JulienKluge/Clock-odial/README.md

# Clock'odial 🐊

Clock'odial is a PCB board which does frequency and clock signal processing.
