JulienKluge/Clock-odial/extern/LFE5U-25F-6BG256C/Pinout/FPGA-SC-02033-2-0-ECP5U-25-Pinout.xlsx

# Pin Out For ECP5U-25
# Revision 1.1 - Include CABGA256 package
# Revised Oct. 17 | 2017
# Revision 2.0 - Include TQFP144 package
# Revised Sep. 17 | 2021
PAD | Pin/Ball Function | Bank | Dual Function | Differential | High Speed | DQS | CABGA256
1 | PL2A | 7 | - | True_OF_PL2B | TRUE | LDQ8 | B1
2 | PL2B | 7 | - | Comp_OF_PL2A | TRUE | LDQ8 | B2
3 | VSSIO7 | - | - | - | - | - | -
4 | PL2C | 7 | - | True_OF_PL2D | - | LDQ8 | C3
5 | VCCIO7 | - | - | - | - | - | -
6 | PL2D | 7 | - | Comp_OF_PL2C | - | LDQ8 | D3
7 | PL5A | 7 | - | True_OF_PL5B | TRUE | LDQ8 | C1
8 | VCCAUX | - | - | - | - | - | -
9 | PL5C | 7 | - | True_OF_PL5D | - | LDQ8 | E3
10 | PL5B | 7 | - | Comp_OF_PL5A | TRUE | LDQ8 | C2
11 | VSS | - | - | - | - | - | -
12 | PL5D | 7 | - | Comp_OF_PL5C | - | LDQ8 | F3
13 | PL8A | 7 | - | True_OF_PL8B | TRUE | LDQS8 | D1
14 | VCC | - | - | - | - | - | -
15 | PL8C | 7 | - | True_OF_PL8D | - | LDQ8 | F4
16 | PL8B | 7 | - | Comp_OF_PL8A | TRUE | LDQSN8 | E2
17 | VSS | - | - | - | - | - | -
18 | PL8D | 7 | - | Comp_OF_PL8C | - | LDQ8 | F5
19 | PL11A | 7 | - | True_OF_PL11B | TRUE | LDQ8 | G5
20 | VSSIO7 | - | - | - | - | - | -
21 | PL11C | 7 | - | True_OF_PL11D | - | LDQ8 | F2
22 | PL11B | 7 | - | Comp_OF_PL11A | TRUE | LDQ8 | G4
23 | VCCIO7 | - | - | - | - | - | -
24 | PL11D | 7 | - | Comp_OF_PL11C | - | LDQ8 | E1
25 | PL14A | 7 | - | True_OF_PL14B | TRUE | LDQ20 | F1
26 | VSSIO7 | - | - | - | - | - | -
27 | PL14C | 7 | VREF1_7 | True_OF_PL14D | - | LDQ20 | G3
28 | PL14B | 7 | - | Comp_OF_PL14A | TRUE | LDQ20 | G2
29 | VCCIO7 | - | - | - | - | - | -
30 | PL14D | 7 | - | Comp_OF_PL14C | - | LDQ20 | H3
31 | PL17A | 7 | - | True_OF_PL17B | TRUE | LDQ20 | H5
32 | VCCAUX | - | - | - | - | - | -
33 | PL17C | 7 | - | True_OF_PL17D | - | LDQ20 | J4
34 | PL17B | 7 | - | Comp_OF_PL17A | TRUE | LDQ20 | H4
35 | VSS | - | - | - | - | - | -
36 | PL17D | 7 | - | Comp_OF_PL17C | - | LDQ20 | J5
37 | PL20A | 7 | GR_PCLK7_1 | True_OF_PL20B | TRUE | LDQS20 | G1
38 | VCC | - | - | - | - | - | -
39 | PL20C | 7 | GR_PCLK7_0 | True_OF_PL20D | - | LDQ20 | J3
40 | PL20B | 7 | - | Comp_OF_PL20A | TRUE | LDQSN20 | H2
41 | VSS | - | - | - | - | - | -
42 | PL20D | 7 | - | Comp_OF_PL20C | - | LDQ20 | K3
43 | PL23A | 7 | PCLKT7_1 | True_OF_PL23B | TRUE | LDQ20 | J1
44 | VSSIO7 | - | - | - | - | - | -
45 | PL23C | 7 | PCLKT7_0 | True_OF_PL23D | - | LDQ20 | K1
46 | PL23B | 7 | PCLKC7_1 | Comp_OF_PL23A | TRUE | LDQ20 | J2
47 | VCCIO7 | - | - | - | - | - | -
48 | PL23D | 7 | PCLKC7_0 | Comp_OF_PL23C | - | LDQ20 | K2
49 | PL26A | 6 | PCLKT6_1 | True_OF_PL26B | TRUE | LDQ32 | L1
50 | VSSIO6 | - | - | - | - | - | -
51 | PL26C | 6 | PCLKT6_0 | True_OF_PL26D | - | LDQ32 | M1
52 | PL26B | 6 | PCLKC6_1 | Comp_OF_PL26A | TRUE | LDQ32 | L2
53 | VCCIO6 | - | - | - | - | - | -
54 | PL26D | 6 | PCLKC6_0 | Comp_OF_PL26C | - | LDQ32 | M2
55 | PL29A | 6 | GR_PCLK6_0 | True_OF_PL29B | TRUE | LDQ32 | K4
56 | VCCAUX | - | - | - | - | - | -
57 | PL29C | 6 | GR_PCLK6_1 | True_OF_PL29D | - | LDQ32 | L4
58 | PL29B | 6 | - | Comp_OF_PL29A | TRUE | LDQ32 | K5
59 | VSS | - | - | - | - | - | -
60 | PL29D | 6 | - | Comp_OF_PL29C | - | LDQ32 | L5
61 | PL32A | 6 | - | True_OF_PL32B | TRUE | LDQS32 | N1
62 | VCC | - | - | - | - | - | -
63 | PL32C | 6 | - | True_OF_PL32D | - | LDQ32 | L3
64 | PL32B | 6 | - | Comp_OF_PL32A | TRUE | LDQSN32 | P2
65 | VSS | - | - | - | - | - | -
66 | PL32D | 6 | - | Comp_OF_PL32C | - | LDQ32 | M3
67 | PL35A | 6 | - | True_OF_PL35B | TRUE | LDQ32 | P1
68 | VSSIO6 | - | - | - | - | - | -
69 | PL35C | 6 | - | True_OF_PL35D | - | LDQ32 | M4
70 | PL35B | 6 | VREF1_6 | Comp_OF_PL35A | TRUE | LDQ32 | R1
71 | VCCIO6 | - | - | - | - | - | -
72 | PL35D | 6 | - | Comp_OF_PL35C | - | LDQ32 | N3
73 | PL38A | 6 | - | True_OF_PL38B | TRUE | LDQ44 | N4
74 | VSSIO6 | - | - | - | - | - | -
75 | PL38C | 6 | - | True_OF_PL38D | - | LDQ44 | R2
76 | PL38B | 6 | - | Comp_OF_PL38A | TRUE | LDQ44 | P3
77 | VCCIO6 | - | - | - | - | - | -
78 | PL38D | 6 | - | Comp_OF_PL38C | - | LDQ44 | T2
79 | PL41A | 6 | - | True_OF_PL41B | TRUE | LDQ44 | P4
80 | VCCAUX | - | - | - | - | - | -
81 | PL41C | 6 | - | True_OF_PL41D | - | LDQ44 | R4
82 | PL41B | 6 | - | Comp_OF_PL41A | TRUE | LDQ44 | R3
83 | VSS | - | - | - | - | - | -
84 | PL41D | 6 | - | Comp_OF_PL41C | - | LDQ44 | T3
85 | PL44A | 6 | - | True_OF_PL44B | TRUE | LDQS44 | R5
86 | VCC | - | - | - | - | - | -
87 | PL44C | 6 | - | True_OF_PL44D | - | LDQ44 | M5
88 | PL44B | 6 | - | Comp_OF_PL44A | TRUE | LDQSN44 | T4
89 | VSS | - | - | - | - | - | -
90 | PL44D | 6 | - | Comp_OF_PL44C | - | LDQ44 | N5
91 | PL47A | 6 | - | True_OF_PL47B | TRUE | LDQ44 | M6
92 | VSSIO6 | - | - | - | - | - | -
93 | PL47B | 6 | - | Comp_OF_PL47A | TRUE | LDQ44 | N6
94 | VCCIO6 | - | - | - | - | - | -
95 | PL47C | 6 | LLC_GPLL0T_IN | True_OF_PL47D | - | LDQ44 | P6
96 | PL47D | 6 | LLC_GPLL0C_IN | Comp_OF_PL47C | - | LDQ44 | P5
97 | NC | - | - | - | - | - | -
98 | NC | - | - | - | - | - | -
99 | GND | - | - | - | - | - | -
100 | VCC | - | - | - | - | - | -
101 | VCC | - | - | - | - | - | -
102 | VSS | - | - | - | - | - | -
103 | PB4A | 8 | D7/IO7 | True_OF_PB4B | - | - | T6
104 | PB6A | 8 | D5/MISO2/IO5 | True_OF_PB6B | - | - | R7
105 | VCC | - | - | - | - | - | -
106 | PB4B | 8 | D6/IO6 | Comp_OF_PB4A | - | - | R6
107 | PB6B | 8 | D4/MOSI2/IO4 | Comp_OF_PB6A | - | - | P7
108 | VSS | - | - | - | - | - | -
109 | PB9A | 8 | D3/IO3 | True_OF_PB9B | - | - | N7
110 | PB11A | 8 | D1/MISO/IO1 | True_OF_PB11B | - | - | T7
111 | VSSIO8 | - | - | - | - | - | -
112 | PB9B | 8 | D2/IO2 | Comp_OF_PB9A | - | - | M7
113 | PB11B | 8 | D0/MOSI/IO0 | Comp_OF_PB11A | - | - | T8
114 | VCCIO8 | - | - | - | - | - | -
115 | PB13A | 8 | SN/CSN | True_OF_PB13B | - | - | R8
116 | PB15A | 8 | HOLDN/DI/BUSY/CSSPIN/CEN | True_OF_PB15B | - | - | N8
117 | VSSIO8 | - | - | - | - | - | -
118 | PB13B | 8 | CS1N | Comp_OF_PB13A | - | - | P8
119 | PB15B | 8 | DOUT/CSON | Comp_OF_PB15A | - | - | M8
120 | VCCIO8 | - | - | - | - | - | -
121 | PB18A | 8 | WRITEN | - | - | - | M9
122 | INITN | 8 | - | - | - | - | T9
123 | VCCAUX | - | - | - | - | - | -
124 | CCLK | 8 | MCLK/SCK | - | - | - | N9
125 | PROGRAMN | 8 | - | - | - | - | R9
126 | VSS | - | - | - | - | - | -
127 | DONE | 8 | - | - | - | - | P9
128 | CFG_1 | 8 | - | - | - | - | P10
129 | VCC | - | - | - | - | - | -
130 | CFG_2 | 8 | - | - | - | - | R10
131 | CFG_0 | 8 | - | - | - | - | N10
132 | VSS | - | - | - | - | - | -
133 | TDO | 40 | - | - | - | - | M10
134 | TCK | 40 | - | - | - | - | T10
135 | VSSIO8 | - | - | - | - | - | -
136 | TDI | 40 | - | - | - | - | R11
137 | TMS | 40 | - | - | - | - | T11
138 | VCCIO8 | - | - | - | - | - | -
139 | VCC | - | - | - | - | - | -
140 | VCC | - | - | - | - | - | -
141 | VSS | - | - | - | - | - | -
142 | VSS | - | - | - | - | - | -
143 | VCC | - | - | - | - | - | -
144 | VCC | - | - | - | - | - | -
145 | GND | - | - | - | - | - | -
146 | GND | - | - | - | - | - | -
147 | RESERVED | - | - | - | - | - | -
148 | GND | - | - | - | - | - | -
149 | RESERVED | - | - | - | - | - | -
150 | GND | - | - | - | - | - | -
151 | GND | - | - | - | - | - | -
152 | GND | - | - | - | - | - | -
153 | GND | - | - | - | - | - | -
154 | GND | - | - | - | - | - | -
155 | GND | - | - | - | - | - | -
156 | GND | - | - | - | - | - | -
157 | GND | - | - | - | - | - | -
158 | GND | - | - | - | - | - | -
159 | GND | - | - | - | - | - | -
160 | GND | - | - | - | - | - | -
161 | GND | - | - | - | - | - | -
162 | GND | - | - | - | - | - | -
163 | GND | - | - | - | - | - | -
164 | RESERVED | - | - | - | - | - | -
165 | GND | - | - | - | - | - | -
166 | RESERVED | - | - | - | - | - | -
167 | GND | - | - | - | - | - | -
168 | GND | - | - | - | - | - | -
169 | RESERVED | - | - | - | - | - | -
170 | GND | - | - | - | - | - | -
171 | RESERVED | - | - | - | - | - | -
172 | GND | - | - | - | - | - | -
173 | GND | - | - | - | - | - | -
174 | GND | - | - | - | - | - | -
175 | GND | - | - | - | - | - | -
176 | GND | - | - | - | - | - | -
177 | VCC | - | - | - | - | - | -
178 | VSS | - | - | - | - | - | -
179 | VCC | - | - | - | - | - | -
180 | GND | - | - | - | - | - | -
181 | NC | - | - | - | - | - | -
182 | NC | - | - | - | - | - | -
183 | PR47D | 3 | LRC_GPLL0C_IN | Comp_OF_PR47C | - | RDQ44 | P12
184 | PR47C | 3 | LRC_GPLL0T_IN | True_OF_PR47D | - | RDQ44 | P11
185 | VCCIO3 | - | - | - | - | - | -
186 | PR47B | 3 | - | Comp_OF_PR47A | TRUE | RDQ44 | N11
187 | VSSIO3 | - | - | - | - | - | -
188 | PR47A | 3 | - | True_OF_PR47B | TRUE | RDQ44 | M11
189 | PR44D | 3 | - | Comp_OF_PR44C | - | RDQ44 | N12
190 | VSS | - | - | - | - | - | -
191 | PR44B | 3 | - | Comp_OF_PR44A | TRUE | RDQSN44 | T13
192 | PR44C | 3 | - | True_OF_PR44D | - | RDQ44 | M12
193 | VCC | - | - | - | - | - | -
194 | PR44A | 3 | - | True_OF_PR44B | TRUE | RDQS44 | R12
195 | PR41D | 3 | - | Comp_OF_PR41C | - | RDQ44 | T14
196 | VSS | - | - | - | - | - | -
197 | PR41B | 3 | - | Comp_OF_PR41A | TRUE | RDQ44 | R14
198 | PR41C | 3 | - | True_OF_PR41D | - | RDQ44 | R13
199 | VCCAUX | - | - | - | - | - | -
200 | PR41A | 3 | - | True_OF_PR41B | TRUE | RDQ44 | P13
201 | PR38D | 3 | - | Comp_OF_PR38C | - | RDQ44 | T15
202 | VCCIO3 | - | - | - | - | - | -
203 | PR38B | 3 | - | Comp_OF_PR38A | TRUE | RDQ44 | P14
204 | PR38C | 3 | - | True_OF_PR38D | - | RDQ44 | R15
205 | VSSIO3 | - | - | - | - | - | -
206 | PR38A | 3 | - | True_OF_PR38B | TRUE | RDQ44 | N13
207 | PR35D | 3 | - | Comp_OF_PR35C | - | RDQ32 | N14
208 | VCCIO3 | - | - | - | - | - | -
209 | PR35B | 3 | VREF1_3 | Comp_OF_PR35A | TRUE | RDQ32 | R16
210 | PR35C | 3 | - | True_OF_PR35D | - | RDQ32 | M13
211 | VSSIO3 | - | - | - | - | - | -
212 | PR35A | 3 | - | True_OF_PR35B | TRUE | RDQ32 | P16
213 | PR32D | 3 | - | Comp_OF_PR32C | - | RDQ32 | M14
214 | VSS | - | - | - | - | - | -
215 | PR32B | 3 | - | Comp_OF_PR32A | TRUE | RDQSN32 | P15
216 | PR32C | 3 | - | True_OF_PR32D | - | RDQ32 | L14
217 | VCC | - | - | - | - | - | -
218 | PR32A | 3 | - | True_OF_PR32B | TRUE | RDQS32 | N16
219 | PR29D | 3 | - | Comp_OF_PR29C | - | RDQ32 | L12
220 | VSS | - | - | - | - | - | -
221 | PR29B | 3 | - | Comp_OF_PR29A | TRUE | RDQ32 | K12
222 | PR29C | 3 | GR_PCLK3_1 | True_OF_PR29D | - | RDQ32 | L13
223 | VCCAUX | - | - | - | - | - | -
224 | PR29A | 3 | GR_PCLK3_0 | True_OF_PR29B | TRUE | RDQ32 | K13
225 | PR26D | 3 | PCLKC3_0 | Comp_OF_PR26C | - | RDQ32 | M15
226 | VCCIO3 | - | - | - | - | - | -
227 | PR26B | 3 | PCLKC3_1 | Comp_OF_PR26A | TRUE | RDQ32 | L15
228 | PR26C | 3 | PCLKT3_0 | True_OF_PR26D | - | RDQ32 | M16
229 | VSSIO3 | - | - | - | - | - | -
230 | PR26A | 3 | PCLKT3_1 | True_OF_PR26B | TRUE | RDQ32 | L16
231 | PR23D | 2 | PCLKC2_0 | Comp_OF_PR23C | - | RDQ20 | K15
232 | VCCIO2 | - | - | - | - | - | -
233 | PR23B | 2 | PCLKC2_1 | Comp_OF_PR23A | TRUE | RDQ20 | J15
234 | PR23C | 2 | PCLKT2_0 | True_OF_PR23D | - | RDQ20 | K16
235 | VSSIO2 | - | - | - | - | - | -
236 | PR23A | 2 | PCLKT2_1 | True_OF_PR23B | TRUE | RDQ20 | J16
237 | PR20D | 2 | - | Comp_OF_PR20C | - | RDQ20 | K14
238 | VSS | - | - | - | - | - | -
239 | PR20B | 2 | - | Comp_OF_PR20A | TRUE | RDQSN20 | H15
240 | PR20C | 2 | GR_PCLK2_0 | True_OF_PR20D | - | RDQ20 | J14
241 | VCC | - | - | - | - | - | -
242 | PR20A | 2 | GR_PCLK2_1 | True_OF_PR20B | TRUE | RDQS20 | G16
243 | PR17D | 2 | - | Comp_OF_PR17C | - | RDQ20 | J12
244 | VSS | - | - | - | - | - | -
245 | PR17B | 2 | - | Comp_OF_PR17A | TRUE | RDQ20 | H13
246 | PR17C | 2 | - | True_OF_PR17D | - | RDQ20 | J13
247 | VCCAUX | - | - | - | - | - | -
248 | PR17A | 2 | - | True_OF_PR17B | TRUE | RDQ20 | H12
249 | PR14D | 2 | - | Comp_OF_PR14C | - | RDQ20 | H14
250 | VCCIO2 | - | - | - | - | - | -
251 | PR14B | 2 | - | Comp_OF_PR14A | TRUE | RDQ20 | G15
252 | PR14C | 2 | VREF1_2 | True_OF_PR14D | - | RDQ20 | G14
253 | VSSIO2 | - | - | - | - | - | -
254 | PR14A | 2 | - | True_OF_PR14B | TRUE | RDQ20 | F16
255 | PR11D | 2 | - | Comp_OF_PR11C | - | RDQ8 | E16
256 | VCCIO2 | - | - | - | - | - | -
257 | PR11B | 2 | - | Comp_OF_PR11A | TRUE | RDQ8 | G13
258 | PR11C | 2 | - | True_OF_PR11D | - | RDQ8 | F15
259 | VSSIO2 | - | - | - | - | - | -
260 | PR11A | 2 | - | True_OF_PR11B | TRUE | RDQ8 | G12
261 | PR8D | 2 | - | Comp_OF_PR8C | - | RDQ8 | F12
262 | VSS | - | - | - | - | - | -
263 | PR8B | 2 | - | Comp_OF_PR8A | TRUE | RDQSN8 | E15
264 | PR8C | 2 | - | True_OF_PR8D | - | RDQ8 | F13
265 | VCC | - | - | - | - | - | -
266 | PR8A | 2 | - | True_OF_PR8B | TRUE | RDQS8 | D16
267 | PR5D | 2 | - | Comp_OF_PR5C | - | RDQ8 | F14
268 | VSS | - | - | - | - | - | -
269 | PR5B | 2 | - | Comp_OF_PR5A | TRUE | RDQ8 | C15
270 | PR5C | 2 | - | True_OF_PR5D | - | RDQ8 | E14
271 | VCCAUX | - | - | - | - | - | -
272 | PR5A | 2 | - | True_OF_PR5B | TRUE | RDQ8 | C16
273 | PR2D | 2 | - | Comp_OF_PR2C | - | RDQ8 | D14
274 | VCCIO2 | - | - | - | - | - | -
275 | PR2C | 2 | - | True_OF_PR2D | - | RDQ8 | C14
276 | VSSIO2 | - | - | - | - | - | -
277 | PR2B | 2 | S0_IN | Comp_OF_PR2A | TRUE | RDQ8 | B15
278 | PR2A | 2 | - | True_OF_PR2B | TRUE | RDQ8 | B16
279 | GND | - | - | - | - | - | -
280 | VCC | - | - | - | - | - | -
281 | VSS | - | - | - | - | - | -
282 | VCC | - | - | - | - | - | -
283 | PT67B | 1 | - | Comp_OF_PT67A | - | - | A15
284 | VCCIO1 | - | - | - | - | - | -
285 | PT65B | 1 | - | Comp_OF_PT65A | - | - | A14
286 | PT67A | 1 | - | True_OF_PT67B | - | - | B14
287 | VSSIO1 | - | - | - | - | - | -
288 | PT65A | 1 | - | True_OF_PT65B | - | - | A13
289 | PT62B | 1 | - | Comp_OF_PT62A | - | - | E13
290 | VSS | - | - | - | - | - | -
291 | PT60B | 1 | - | Comp_OF_PT60A | - | - | C13
292 | PT62A | 1 | - | True_OF_PT62B | - | - | D13
293 | VCC | - | - | - | - | - | -
294 | PT60A | 1 | - | True_OF_PT60B | - | - | B13
295 | PT58B | 1 | - | Comp_OF_PT58A | - | - | E12
296 | VSS | - | - | - | - | - | -
297 | PT56B | 1 | - | Comp_OF_PT56A | - | - | C12
298 | PT58A | 1 | - | True_OF_PT58B | - | - | D12
299 | VCCAUX | - | - | - | - | - | -
300 | PT56A | 1 | - | True_OF_PT56B | - | - | B12
301 | PT53B | 1 | - | Comp_OF_PT53A | - | - | A12
302 | VCCIO1 | - | - | - | - | - | -
303 | PT51B | 1 | - | Comp_OF_PT51A | - | - | E11
304 | PT53A | 1 | - | True_OF_PT53B | - | - | A11
305 | VSSIO1 | - | - | - | - | - | -
306 | PT51A | 1 | - | True_OF_PT51B | - | - | D11
307 | PT49B | 1 | - | Comp_OF_PT49A | - | - | C11
308 | VCCIO1 | - | - | - | - | - | -
309 | PT47B | 1 | - | Comp_OF_PT47A | - | - | E10
310 | PT49A | 1 | - | True_OF_PT49B | - | - | B11
311 | VSSIO1 | - | - | - | - | - | -
312 | PT47A | 1 | - | True_OF_PT47B | - | - | D10
313 | PT44B | 1 | - | Comp_OF_PT44A | - | - | C10
314 | VSS | - | - | - | - | - | -
315 | PT42B | 1 | - | Comp_OF_PT42A | - | - | A10
316 | PT44A | 1 | - | True_OF_PT44B | - | - | B10
317 | VCC | - | - | - | - | - | -
318 | PT42A | 1 | - | True_OF_PT42B | - | - | A9
319 | PT40B | 1 | - | Comp_OF_PT40A | - | - | E9
320 | VSS | - | - | - | - | - | -
321 | PT38B | 1 | GR_PCLK1_1 | Comp_OF_PT38A | - | - | C9
322 | PT40A | 1 | - | True_OF_PT40B | - | - | D9
323 | VCCAUX | - | - | - | - | - | -
324 | PT38A | 1 | GR_PCLK1_0 | True_OF_PT38B | - | - | B9
325 | PT35B | 1 | PCLKC1_0 | Comp_OF_PT35A | - | - | B8
326 | VCCIO1 | - | - | - | - | - | -
327 | PT33B | 1 | PCLKC1_1 | Comp_OF_PT33A | - | - | D8
328 | PT35A | 1 | PCLKT1_0 | True_OF_PT35B | - | - | C8
329 | VSSIO1 | - | - | - | - | - | -
330 | PT33A | 1 | PCLKT1_1 | True_OF_PT33B | - | - | E8
331 | VSS | - | - | - | - | - | -
332 | VCC | - | - | - | - | - | -
333 | PT29B | 0 | PCLKC0_0 | Comp_OF_PT29A | - | - | A8
334 | VCCIO0 | - | - | - | - | - | -
335 | PT27B | 0 | PCLKC0_1 | Comp_OF_PT27A | - | - | B7
336 | PT29A | 0 | PCLKT0_0 | True_OF_PT29B | - | - | A7
337 | VSSIO0 | - | - | - | - | - | -
338 | PT27A | 0 | PCLKT0_1 | True_OF_PT27B | - | - | C7
339 | PT24B | 0 | GR_PCLK0_0 | Comp_OF_PT24A | - | - | D7
340 | VSS | - | - | - | - | - | -
341 | PT22B | 0 | - | Comp_OF_PT22A | - | - | B6
342 | PT24A | 0 | GR_PCLK0_1 | True_OF_PT24B | - | - | E7
343 | VCC | - | - | - | - | - | -
344 | PT22A | 0 | - | True_OF_PT22B | - | - | C6
345 | PT20B | 0 | - | Comp_OF_PT20A | - | - | D6
346 | VSS | - | - | - | - | - | -
347 | PT18B | 0 | - | Comp_OF_PT18A | - | - | A6
348 | PT20A | 0 | - | True_OF_PT20B | - | - | E6
349 | VCCAUX | - | - | - | - | - | -
350 | PT18A | 0 | - | True_OF_PT18B | - | - | A5
351 | PT15B | 0 | - | Comp_OF_PT15A | - | - | B5
352 | VCCIO0 | - | - | - | - | - | -
353 | PT13B | 0 | - | Comp_OF_PT13A | - | - | D5
354 | PT15A | 0 | - | True_OF_PT15B | - | - | C5
355 | VSSIO0 | - | - | - | - | - | -
356 | PT13A | 0 | - | True_OF_PT13B | - | - | E5
357 | PT11B | 0 | - | Comp_OF_PT11A | - | - | B4
358 | VCCIO0 | - | - | - | - | - | -
359 | PT9B | 0 | - | Comp_OF_PT9A | - | - | D4
360 | PT11A | 0 | - | True_OF_PT11B | - | - | C4
361 | VSSIO0 | - | - | - | - | - | -
362 | PT9A | 0 | - | True_OF_PT9B | - | - | E4
363 | PT6B | 0 | - | Comp_OF_PT6A | - | - | A4
364 | VSS | - | - | - | - | - | -
365 | PT4B | 0 | - | Comp_OF_PT4A | - | - | B3
366 | PT6A | 0 | - | True_OF_PT6B | - | - | A3
367 | VCC | - | - | - | - | - | -
368 | PT4A | 0 | - | True_OF_PT4B | - | - | A2
369 | VSS | - | - | - | - | - | -
370 | VCC | - | - | - | - | - | -
371 | VCC | - | - | - | - | - | -
372 | GND | - | - | - | - | - | -
0 | NC | - | - | - | - | - | -
0 | GND | - | - | - | - | - | A16
0 | GND | - | - | - | - | - | H16
0 | GND | - | - | - | - | - | T16
0 | GND | - | - | - | - | - | D15
0 | GND | - | - | - | - | - | N15
0 | GND | - | - | - | - | - | T12
0 | GND | - | - | - | - | - | G10
0 | GND | - | - | - | - | - | H10
0 | GND | - | - | - | - | - | J10
0 | GND | - | - | - | - | - | K10
0 | GND | - | - | - | - | - | F9
0 | GND | - | - | - | - | - | H9
0 | GND | - | - | - | - | - | J9
0 | GND | - | - | - | - | - | K9
0 | GND | - | - | - | - | - | F8
0 | GND | - | - | - | - | - | G8
0 | GND | - | - | - | - | - | H8
0 | GND | - | - | - | - | - | J8
0 | GND | - | - | - | - | - | K8
0 | GND | - | - | - | - | - | K7
0 | GND | - | - | - | - | - | K6
0 | GND | - | - | - | - | - | T5
0 | GND | - | - | - | - | - | D2
0 | GND | - | - | - | - | - | N2
0 | GND | - | - | - | - | - | A1
0 | GND | - | - | - | - | - | H1
0 | GND | - | - | - | - | - | T1
0 | GND | - | - | - | - | - | -
0 | GND | - | - | - | - | - | -
0 | GND | - | - | - | - | - | -
0 | GND | - | - | - | - | - | -
0 | GND | - | - | - | - | - | -
0 | GND | - | - | - | - | - | -
0 | GND | - | - | - | - | - | -
0 | GND | - | - | - | - | - | -
0 | GND | - | - | - | - | - | -
0 | GND | - | - | - | - | - | -
0 | GND | - | - | - | - | - | -
0 | GND | - | - | - | - | - | -
0 | GND | - | - | - | - | - | -
0 | GND | - | - | - | - | - | -
0 | GND | - | - | - | - | - | -
0 | GND | - | - | - | - | - | -
0 | GND | - | - | - | - | - | -
0 | GND | - | - | - | - | - | -
0 | GND | - | - | - | - | - | -
0 | GND | - | - | - | - | - | -
0 | GND | - | - | - | - | - | -
0 | GND | - | - | - | - | - | -
0 | GND | - | - | - | - | - | -
0 | GND | - | - | - | - | - | -
0 | GND | - | - | - | - | - | -
0 | GND | - | - | - | - | - | -
0 | GND | - | - | - | - | - | -
0 | GND | - | - | - | - | - | -
0 | GND | - | - | - | - | - | -
0 | GND | - | - | - | - | - | -
0 | GND | - | - | - | - | - | -
0 | GND | - | - | - | - | - | -
0 | GND | - | - | - | - | - | -
0 | GND | - | - | - | - | - | -
0 | GND | - | - | - | - | - | -
0 | GND | - | - | - | - | - | -
0 | GND | - | - | - | - | - | -
0 | GND | - | - | - | - | - | -
0 | GND | - | - | - | - | - | -
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
0 | VCCIO6 | 6 | - | - | - | - | -
0 | VCCIO6 | 6 | - | - | - | - | -
0 | VCCIO6 | 6 | - | - | - | - | -
0 | VCCIO7 | 7 | - | - | - | - | -
0 | VCCIO7 | 7 | - | - | - | - | -
0 | VCCIO7 | 7 | - | - | - | - | -
0 | VCCIO7 | 7 | - | - | - | - | H7
0 | VCCIO7 | 7 | - | - | - | - | H6
