JulienKluge/Clock-odial/extern/LFE5U-25F-6BG256C/LFE5UM5G-25_ClockInputs.png

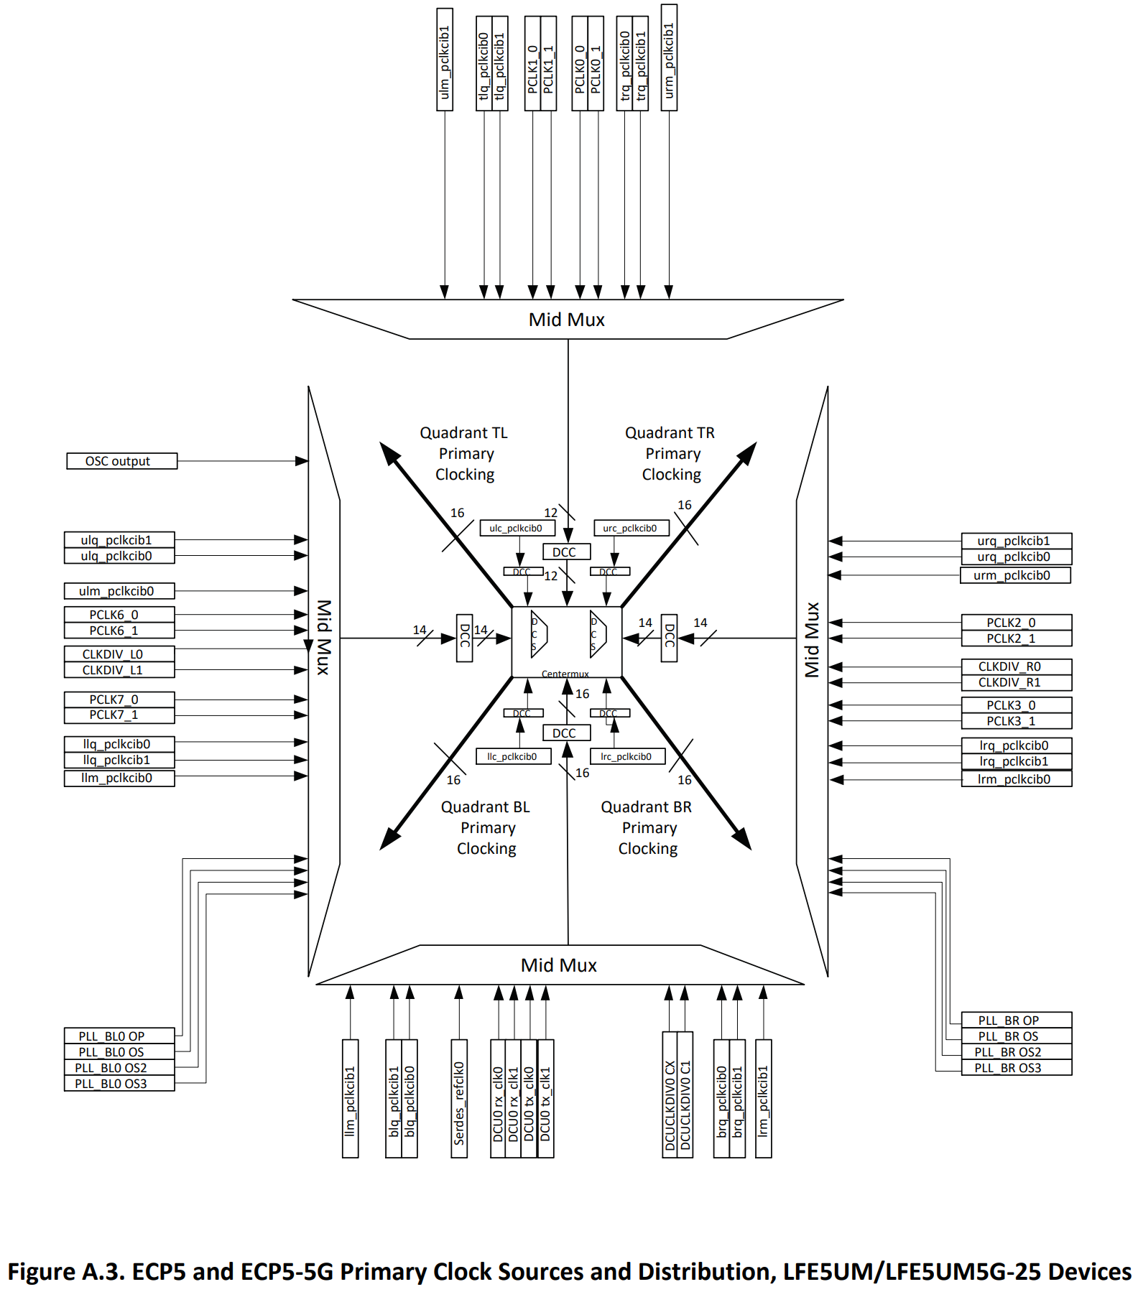
extern/LFE5U-25F-6BG256C/LFE5UM5G-25_ClockInputs.png
