JulienKluge/Clock-odial/extern/TLV62569DBV/Recommended_Layout.png

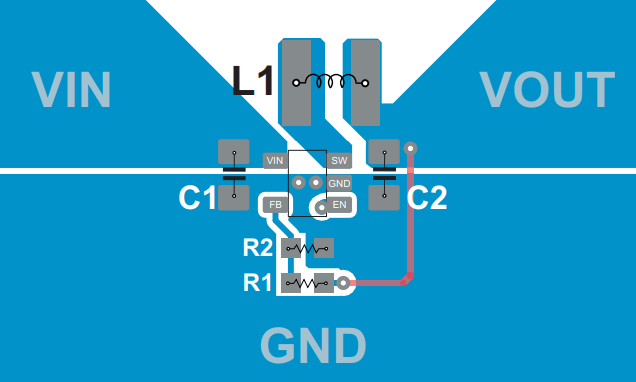
extern/TLV62569DBV/Recommended_Layout.png
