JulienKluge/Clock-odial/(list of files, cad)

Other CAD files:
cad/mount_single/CF125C_M-Step/CF125C_M-Step.ipt
cad/mount_single/Mount_Single.ipt
cad/mount_single/OldVersions/Mount_Single.0002.ipt
cad/mount_single/RS1P4M-Step/RS1P4M-Step.ipt
