JulienKluge/Clock-odial/extern/LT3045EMSE#TRPBF/BestPerformance_Connections.png

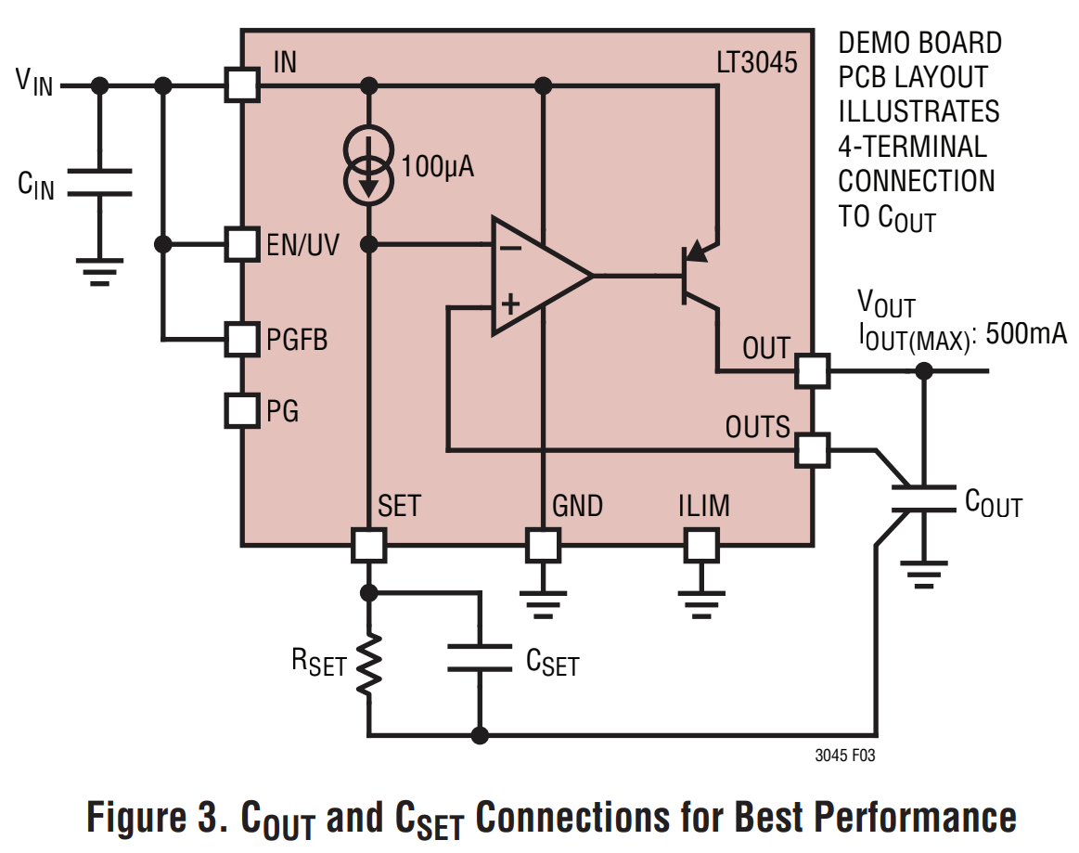
extern/LT3045EMSE#TRPBF/BestPerformance_Connections.png
