JulienKluge/Clock-odial/Clock-odial.kicad_sch

## KiCad design Clock-odial.kicad_sch (2025-08-22)

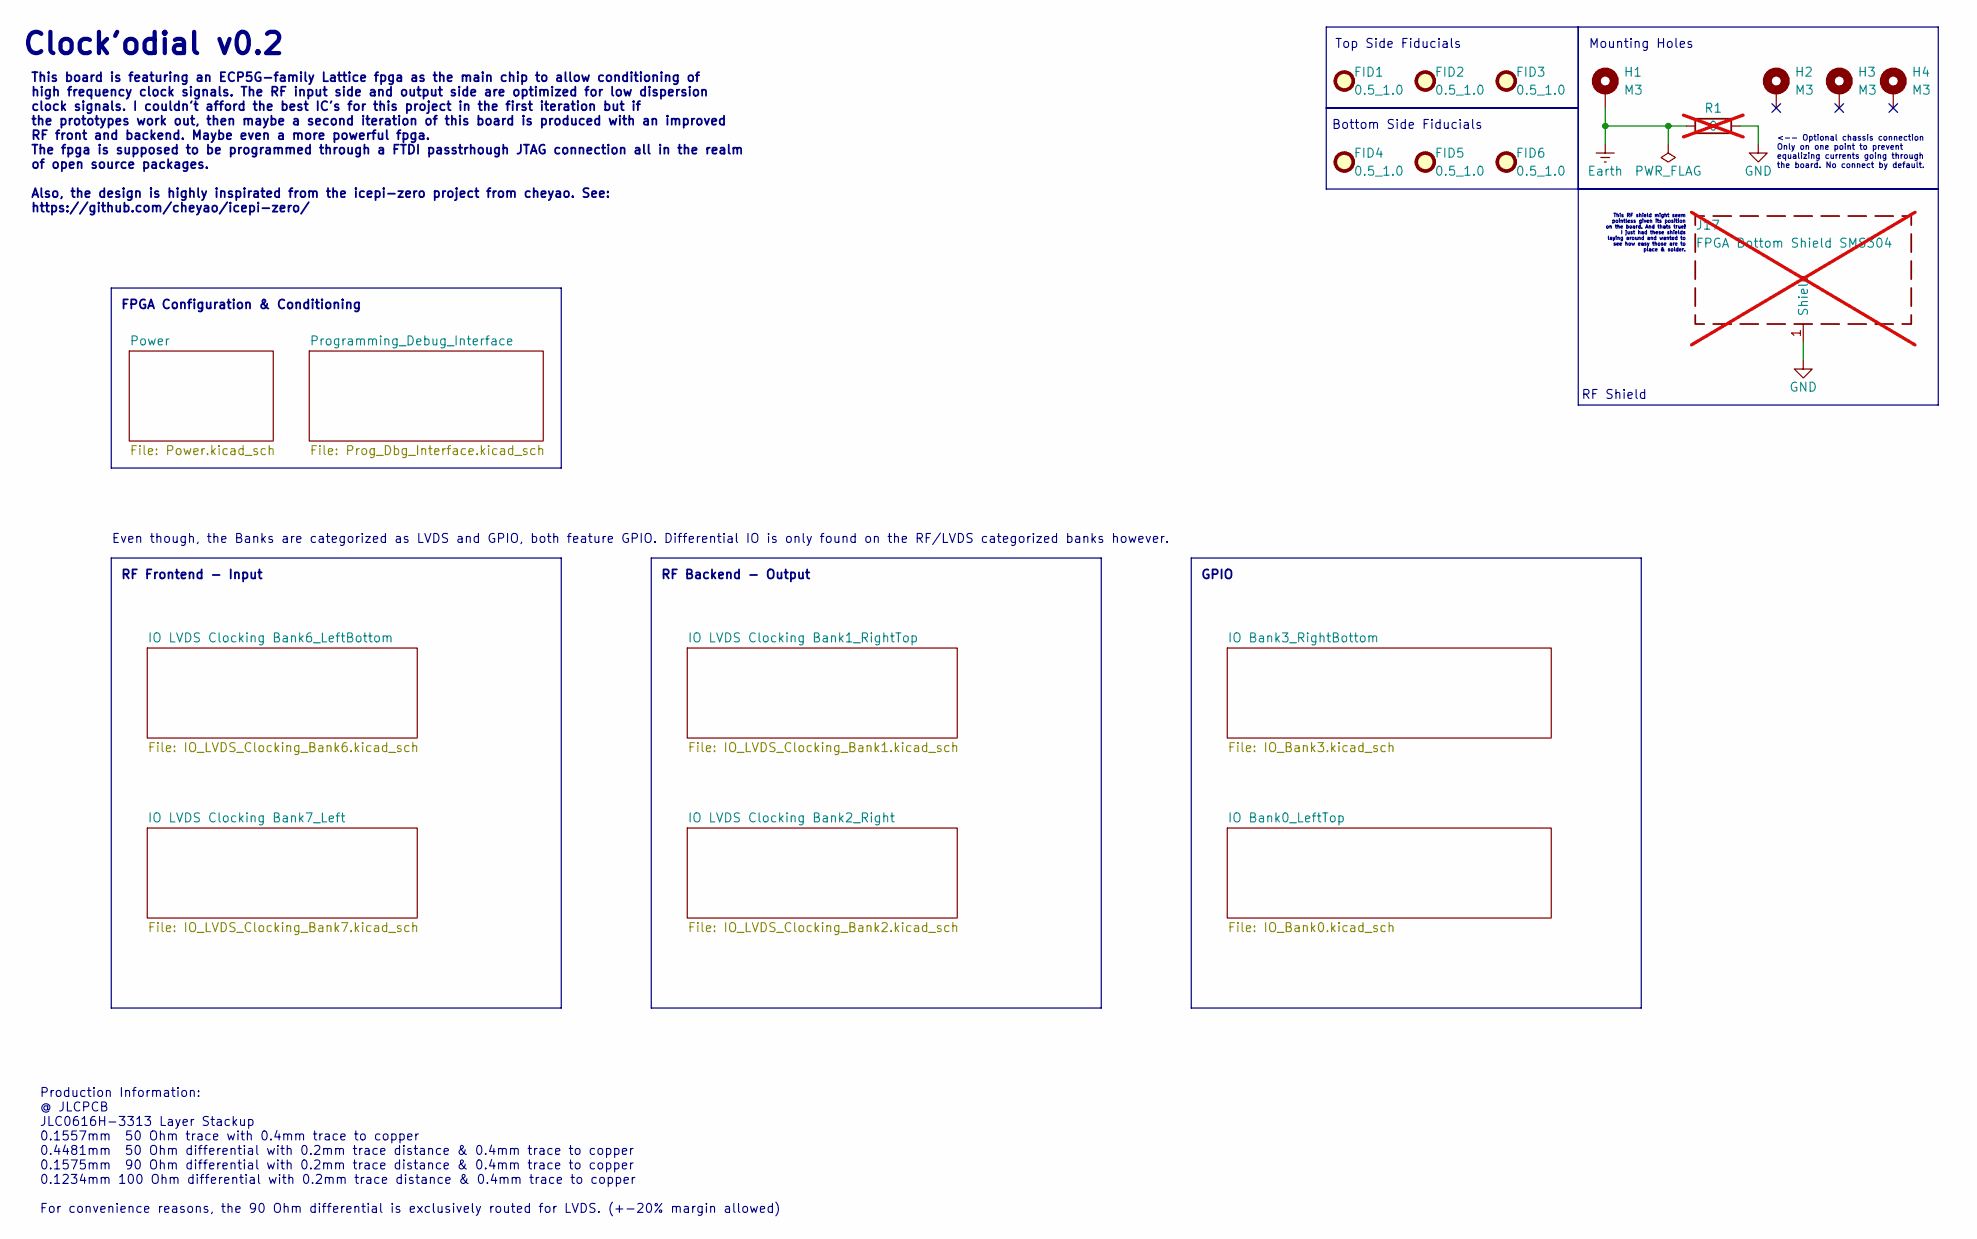
[picture p4: schematic Clock-odial.kicad_sch]

Parts:
FID1, FID2, FID3, FID4, FID5, FID6: 0.5_1.0; Fiducial_0.5mm_Mask1mm
H1, H2, H3, H4: M3; MountingHole_3.2mm_M3_DIN965_Pad_TopBottom
J17: FPGA Bottom Shield SMS304; SMS304; not fitted
R1: 0; R_0603_1608Metric_Pad0.98x0.95mm_HandSolder; not fitted

Connections:
Earth: H1.1, R1.1
GND: J17.1, R1.2

Notes on the sheet:
Clock'odial v0.2
RF Frontend - Input
This board is featuring an ECP5G-family Lattice fpga as the main chip to allow conditioning of high frequency clock signals. The RF input side and output side are optimized for low dispersion clock signals. I couldn't afford the best IC's for this project in the first iteration but if the prototype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
Mounting Holes
FPGA Configuration & Conditioning
Top Side Fiducials
RF Backend - Output
Even though, the Banks are categorized as LVDS and GPIO, both feature GPIO. Differential IO is only found on the RF/LVDS categorized banks however.
Bottom Side Fiducials
GPIO
<-- Optional chassis connection Only on one point to prevent equalizing currents going through the board. No connect by default.
Production Information: @ JLCPCB JLC0616H-3313 Layer Stackup 0.1557mm 50 Ohm trace with 0.4mm trace to copper 0.4481mm 50 Ohm differential with 0.2mm trace distance & 0.4mm trace to copper 0.1575mm 90 Ohm differential with 0.2mm trace distance & 0.4mm trace to copper 0.1234mm 100 Ohm differential w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
This RF shield might seem pointless given its position on the board. And thats true! I just had these shields laying around and wanted to see how easy those are to place & solder.
RF Shield
