JulienKluge/Clock-odial/Clock_Input_Diff_Out.kicad_sch

## KiCad design Clock_Input_Diff_Out.kicad_sch (2025-08-21)

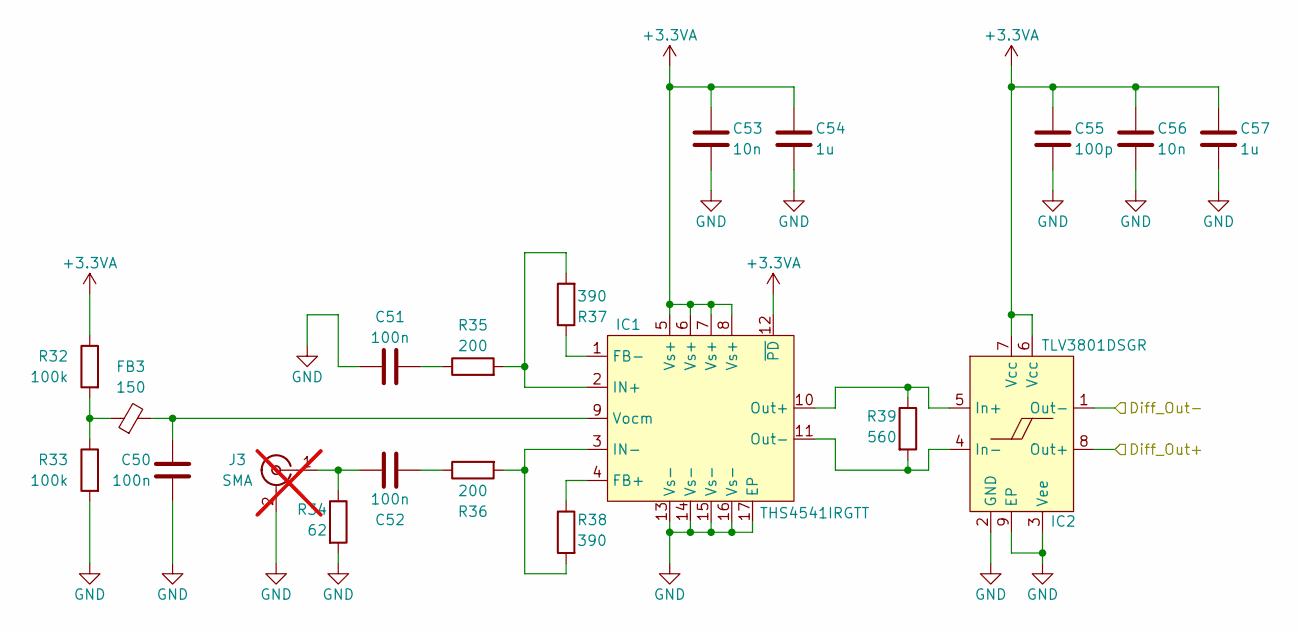
[picture p5: schematic Clock_Input_Diff_Out.kicad_sch]

Parts:
C50, C51, C52: 100n; C_0402_1005Metric
C53, C56: 10n; C_0402_1005Metric
C54, C57: 1u; C_0603_1608Metric
C55: 100p; C_0402_1005Metric
FB3: 150; L_0805_2012Metric
IC1: THS4541IRGTT; VQFN-16-1EP_3x3mm_P0.5mm_EP1.45x1.45mm
IC2: TLV3801DSGR; WSON-8-1EP_2x2mm_P0.5mm_EP0.9x1.6mm
J3: SMA; 73251-115; not fitted
R32, R33: 100k; R_0402_1005Metric
R34: 62; R_0402_1005Metric
R35, R36: 200; R_0402_1005Metric
R37, R38: 390; R_0402_1005Metric
R39: 560; R_0402_1005Metric

Connections:
+3.3VA: C53.1, C54.1, C55.1, C56.1, C57.1, IC1.5 (Vs+), IC1.6 (Vs+), IC1.7 (Vs+), IC1.8 (Vs+), IC1.12 (~PD), IC2.6 (Vcc), IC2.7 (Vcc), R32.1
Diff_Out+: IC2.8 (Out+)
Diff_Out-: IC2.1 (Out-)
GND: C50.2, C51.1, C53.2, C54.2, C55.2, C56.2, C57.2, IC1.13 (Vs-), IC1.14 (Vs-), IC1.15 (Vs-), IC1.16 (Vs-), IC1.17 (EP), IC2.2 (GND), IC2.3 (Vee), IC2.9 (EP), J3.2 (Ext), R33.2, R34.2
unnamed: C50.1, FB3.2, IC1.9 (Vocm)
unnamed: C51.2, R35.1
unnamed: C52.1, J3.1 (In), R34.1
unnamed: C52.2, R36.1
unnamed: FB3.1, R32.2, R33.1
unnamed: IC1.1 (FB-), R37.1
unnamed: IC1.2 (IN+), R35.2, R37.2
unnamed: IC1.3 (IN-), R36.2, R38.2
unnamed: IC1.4 (FB+), R38.1
unnamed: IC1.10 (Out+), IC2.5 (In+), R39.1
unnamed: IC1.11 (Out-), IC2.4 (In-), R39.2
