JulienKluge/Clock-odial/Clock_Input_SingleEnded_Out.kicad_sch

## KiCad design Clock_Input_SingleEnded_Out.kicad_sch (2025-08-22)

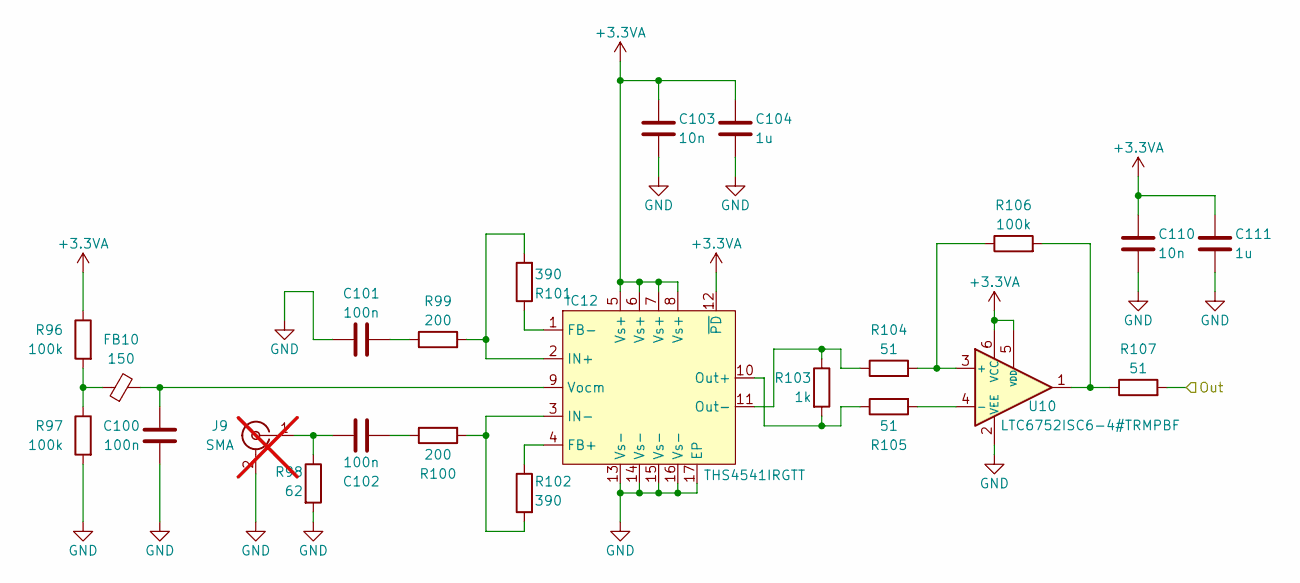
[picture p6: schematic Clock_Input_SingleEnded_Out.kicad_sch]

Parts:
C100, C101, C102: 100n; C_0402_1005Metric
C103, C110: 10n; C_0402_1005Metric
C104, C111: 1u; C_0603_1608Metric
FB10: 150; L_0805_2012Metric
IC12: THS4541IRGTT; VQFN-16-1EP_3x3mm_P0.5mm_EP1.45x1.45mm
J9: SMA; 73251-115; not fitted
R96, R97, R106: 100k; R_0402_1005Metric
R98: 62; R_0402_1005Metric
R99, R100: 200; R_0402_1005Metric
R101, R102: 390; R_0402_1005Metric
R103: 1k; R_0402_1005Metric
R104, R105, R107: 51; R_0402_1005Metric
U10: LTC6752ISC6-4#TRMPBF; SOT-363_SC-70-6

Connections:
+3.3VA: C103.1, C104.1, C110.1, C111.1, IC12.5 (Vs+), IC12.6 (Vs+), IC12.7 (Vs+), IC12.8 (Vs+), IC12.12 (~PD), R96.1, U10.5 (VDD), U10.6 (VCC)
GND: C100.2, C101.1, C103.2, C104.2, C110.2, C111.2, IC12.13 (Vs-), IC12.14 (Vs-), IC12.15 (Vs-), IC12.16 (Vs-), IC12.17 (EP), J9.2 (Ext), R97.2, R98.2, U10.2 (VEE)
unnamed: C100.1, FB10.2, IC12.9 (Vocm)
unnamed: C101.2, R99.1
unnamed: C102.1, J9.1 (In), R98.1
unnamed: C102.2, R100.1
unnamed: FB10.1, R96.2, R97.1
unnamed: IC12.1 (FB-), R101.1
unnamed: IC12.2 (IN+), R99.2, R101.2
unnamed: IC12.3 (IN-), R100.2, R102.2
unnamed: IC12.4 (FB+), R102.1
unnamed: IC12.10 (Out+), R103.2, R105.1
unnamed: IC12.11 (Out-), R103.1, R104.1
unnamed: R104.2, R106.1, U10.3 (+)
unnamed: R105.2, U10.4 (-)
unnamed: R106.2, R107.1, U10.1
Out: R107.2
