JulienKluge/Clock-odial/IO_Bank3.kicad_sch

## KiCad design IO_Bank3.kicad_sch (2025-08-21)

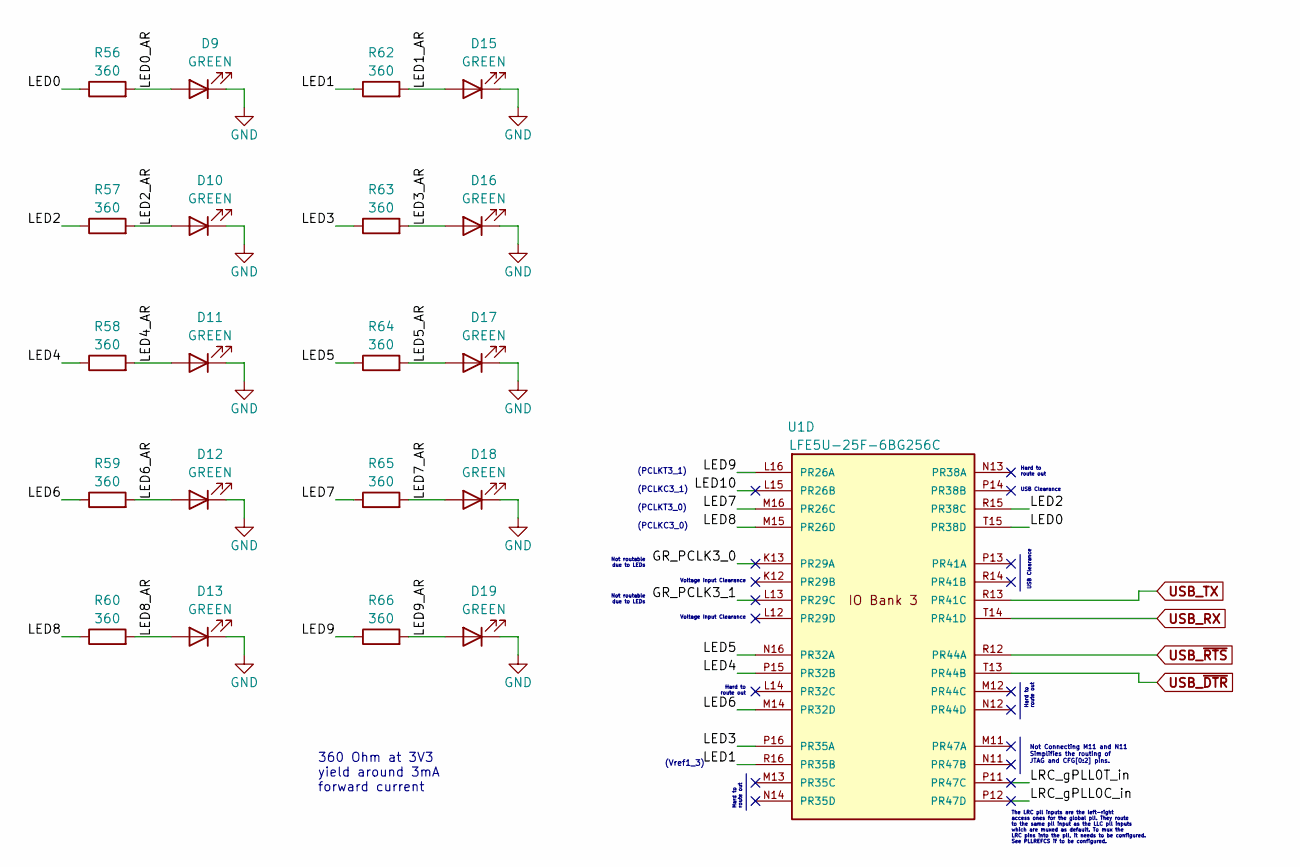
[picture p7: schematic IO_Bank3.kicad_sch]

Parts:
D9, D10, D11, D12, D13, D15, D16, D17, D18, D19: GREEN; LED_0402_1005Metric
R56, R57, R58, R59, R60, R62, R63, R64, R65, R66: 360; R_0402_1005Metric
U1: LFE5U-25F-6BG256C; BGA256C80P16X16_1400X1400X170_Masked

Connections:
GND: D9.1 (K), D10.1 (K), D11.1 (K), D12.1 (K), D13.1 (K), D15.1 (K), D16.1 (K), D17.1 (K), D18.1 (K), D19.1 (K)
GR_PCLK3_0: U1.K13 (PR29A)
GR_PCLK3_1: U1.L13 (PR29C)
LED0: R56.1, U1.T15 (PR38D)
LED0_AR: D9.2 (A), R56.2
LED1: R62.1, U1.R16 (PR35B)
LED1_AR: D15.2 (A), R62.2
LED2: R57.1, U1.R15 (PR38C)
LED2_AR: D10.2 (A), R57.2
LED3: R63.1, U1.P16 (PR35A)
LED3_AR: D16.2 (A), R63.2
LED4: R58.1, U1.P15 (PR32B)
LED4_AR: D11.2 (A), R58.2
LED5: R64.1, U1.N16 (PR32A)
LED5_AR: D17.2 (A), R64.2
LED6: R59.1, U1.M14 (PR32D)
LED6_AR: D12.2 (A), R59.2
LED7: R65.1, U1.M16 (PR26C)
LED7_AR: D18.2 (A), R65.2
LED8: R60.1, U1.M15 (PR26D)
LED8_AR: D13.2 (A), R60.2
LED9: R66.1, U1.L16 (PR26A)
LED9_AR: D19.2 (A), R66.2
LED10: U1.L15 (PR26B)
LRC_gPLL0C_in: U1.P12 (PR47D)
LRC_gPLL0T_in: U1.P11 (PR47C)
USB_RX: U1.T14 (PR41D)
USB_TX: U1.R13 (PR41C)
USB_~DTR: U1.T13 (PR44B)
USB_~RTS: U1.R12 (PR44A)

Notes on the sheet:
Hard to route out
The LRC pll inputs are the left-right access ones for the global pll. They route to the same pll input as the LLC pll inputs which are muxed as default. To mux the LRC pins into the pll, it needs to be configured. See PLLREFCS if to be configured.
Not routable due to LEDs
Not Connecting M11 and N11 Simplifies the routing of JTAG and CFG[0:2] pins.
(PCLKC3_1)
(Vref1_3)
Voltage Input Clearance
USB Clearance
(PCLKC3_0)
(PCLKT3_1)
360 Ohm at 3V3 yield around 3mA forward current
(PCLKT3_0)
