JulienKluge/Clock-odial/IO_LVDS_Clocking_Bank1.kicad_sch

## KiCad design IO_LVDS_Clocking_Bank1.kicad_sch (2025-08-21)

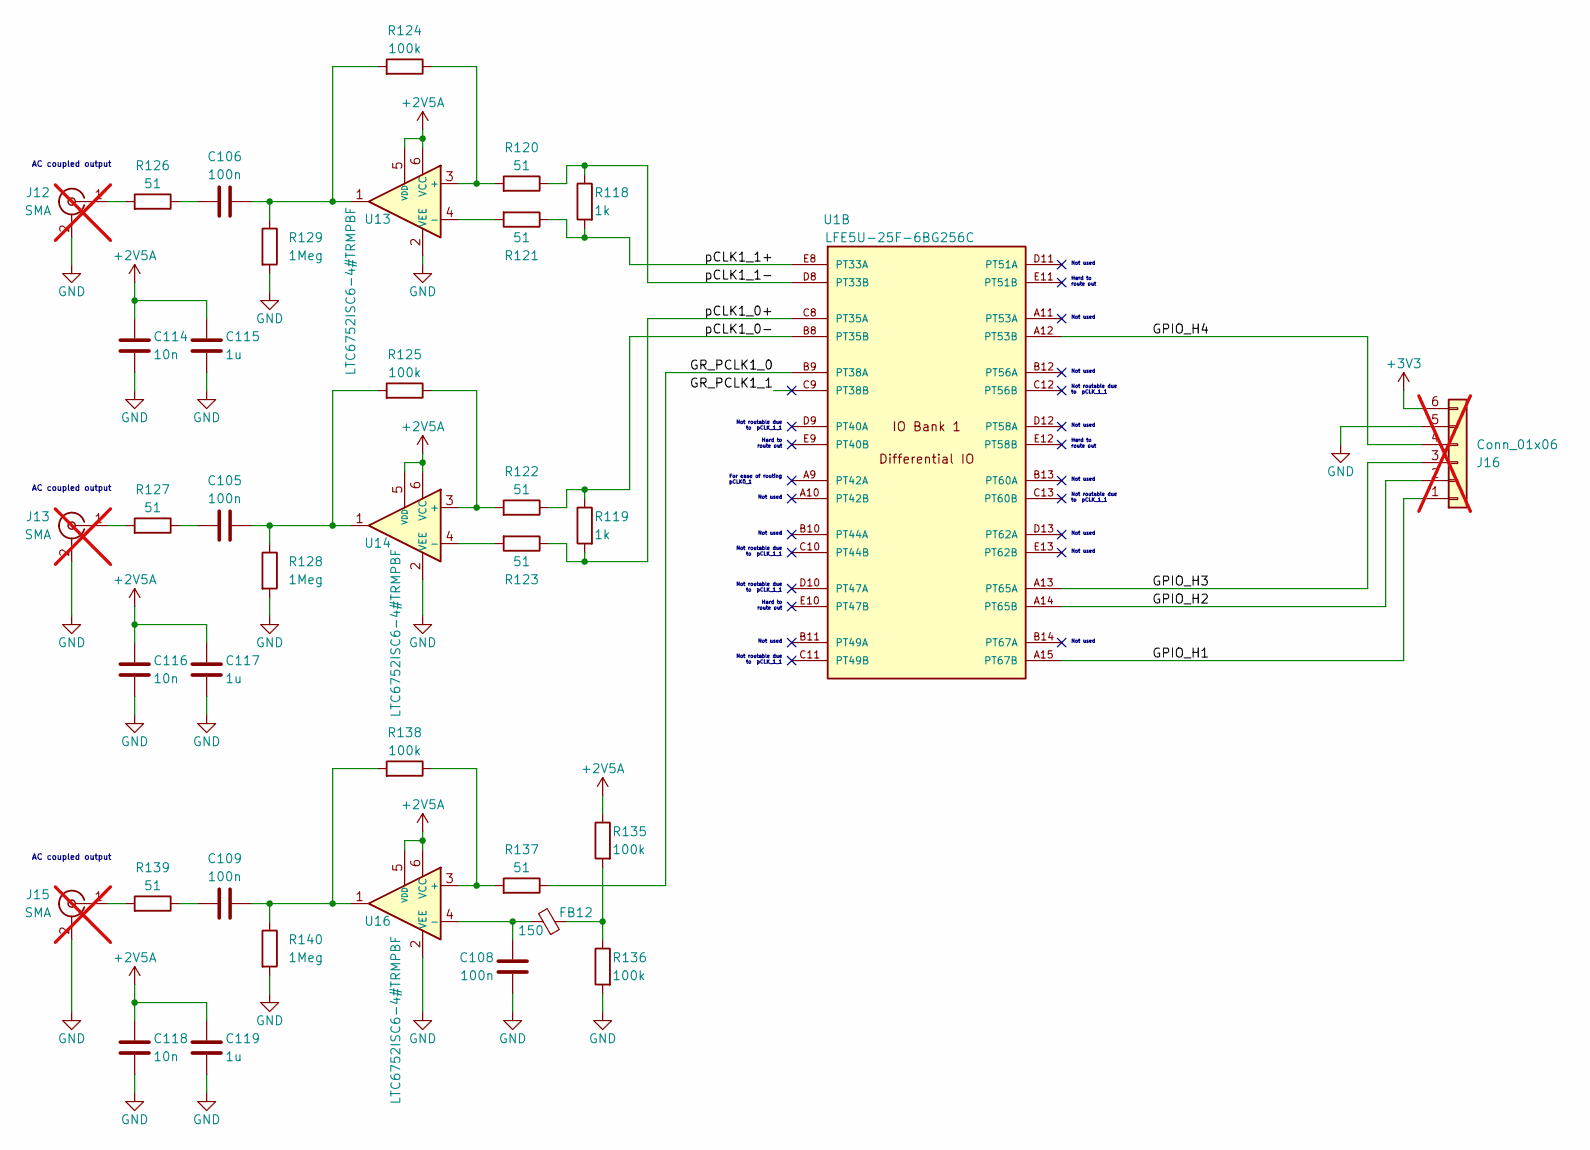
[picture p8: schematic IO_LVDS_Clocking_Bank1.kicad_sch]

Parts:
C105, C106, C108, C109: 100n; C_0402_1005Metric
C114, C116, C118: 10n; C_0402_1005Metric
C115, C117, C119: 1u; C_0603_1608Metric
FB12: 150; L_0805_2012Metric
J12, J13, J15: SMA; 73251-115; not fitted
J16: Conn_01x06; PinHeader_1x06_P2.54mm_Vertical; not fitted
R118, R119: 1k; R_0402_1005Metric
R120, R121, R122, R123, R126, R127, R137, R139: 51; R_0402_1005Metric
R124, R125, R135, R136, R138: 100k; R_0402_1005Metric
R128, R129, R140: 1Meg; R_0402_1005Metric
U1: LFE5U-25F-6BG256C; BGA256C80P16X16_1400X1400X170_Masked
U13, U14, U16: LTC6752ISC6-4#TRMPBF; SOT-363_SC-70-6

Connections:
+2V5A: C114.1, C115.1, C116.1, C117.1, C118.1, C119.1, R135.1, U13.5 (VDD), U13.6 (VCC), U14.5 (VDD), U14.6 (VCC), U16.5 (VDD), U16.6 (VCC)
+3V3: J16.6
GND: C108.2, C114.2, C115.2, C116.2, C117.2, C118.2, C119.2, J12.2 (Ext), J13.2 (Ext), J15.2 (Ext), J16.5, R128.2, R129.2, R136.2, R140.2, U13.2 (VEE), U14.2 (VEE), U16.2 (VEE)
GPIO_H1: J16.1, U1.A15 (PT67B)
GPIO_H2: J16.2, U1.A14 (PT65B)
GPIO_H3: J16.3, U1.A13 (PT65A)
GPIO_H4: J16.4, U1.A12 (PT53B)
GR_PCLK1_0: R137.1, U1.B9 (PT38A)
GR_PCLK1_1: U1.C9 (PT38B)
unnamed: C105.1, R127.1
unnamed: C105.2, R125.2, R128.1, U14.1
unnamed: C106.1, R126.1
unnamed: C106.2, R124.2, R129.1, U13.1
unnamed: C108.1, FB12.2, U16.4 (-)
unnamed: C109.1, R139.1
unnamed: C109.2, R138.2, R140.1, U16.1
unnamed: FB12.1, R135.2, R136.1
unnamed: J12.1 (In), R126.2
unnamed: J13.1 (In), R127.2
unnamed: J15.1 (In), R139.2
unnamed: R120.2, R124.1, U13.3 (+)
unnamed: R121.2, U13.4 (-)
unnamed: R122.2, R125.1, U14.3 (+)
unnamed: R123.2, U14.4 (-)
unnamed: R137.2, R138.1, U16.3 (+)
pCLK1_0+: R119.2, R123.1, U1.C8 (PT35A)
pCLK1_0-: R119.1, R122.1, U1.B8 (PT35B)
pCLK1_1+: R118.2, R121.1, U1.E8 (PT33A)
pCLK1_1-: R118.1, R120.1, U1.D8 (PT33B)

Notes on the sheet:
Not used
Not routable due to pCLK_1_1
For ease of routing pCLK0_1
AC coupled output
Hard to route out
