JulienKluge/Clock-odial/IO_LVDS_Clocking_Bank2.kicad_sch

## KiCad design IO_LVDS_Clocking_Bank2.kicad_sch (2025-08-21)

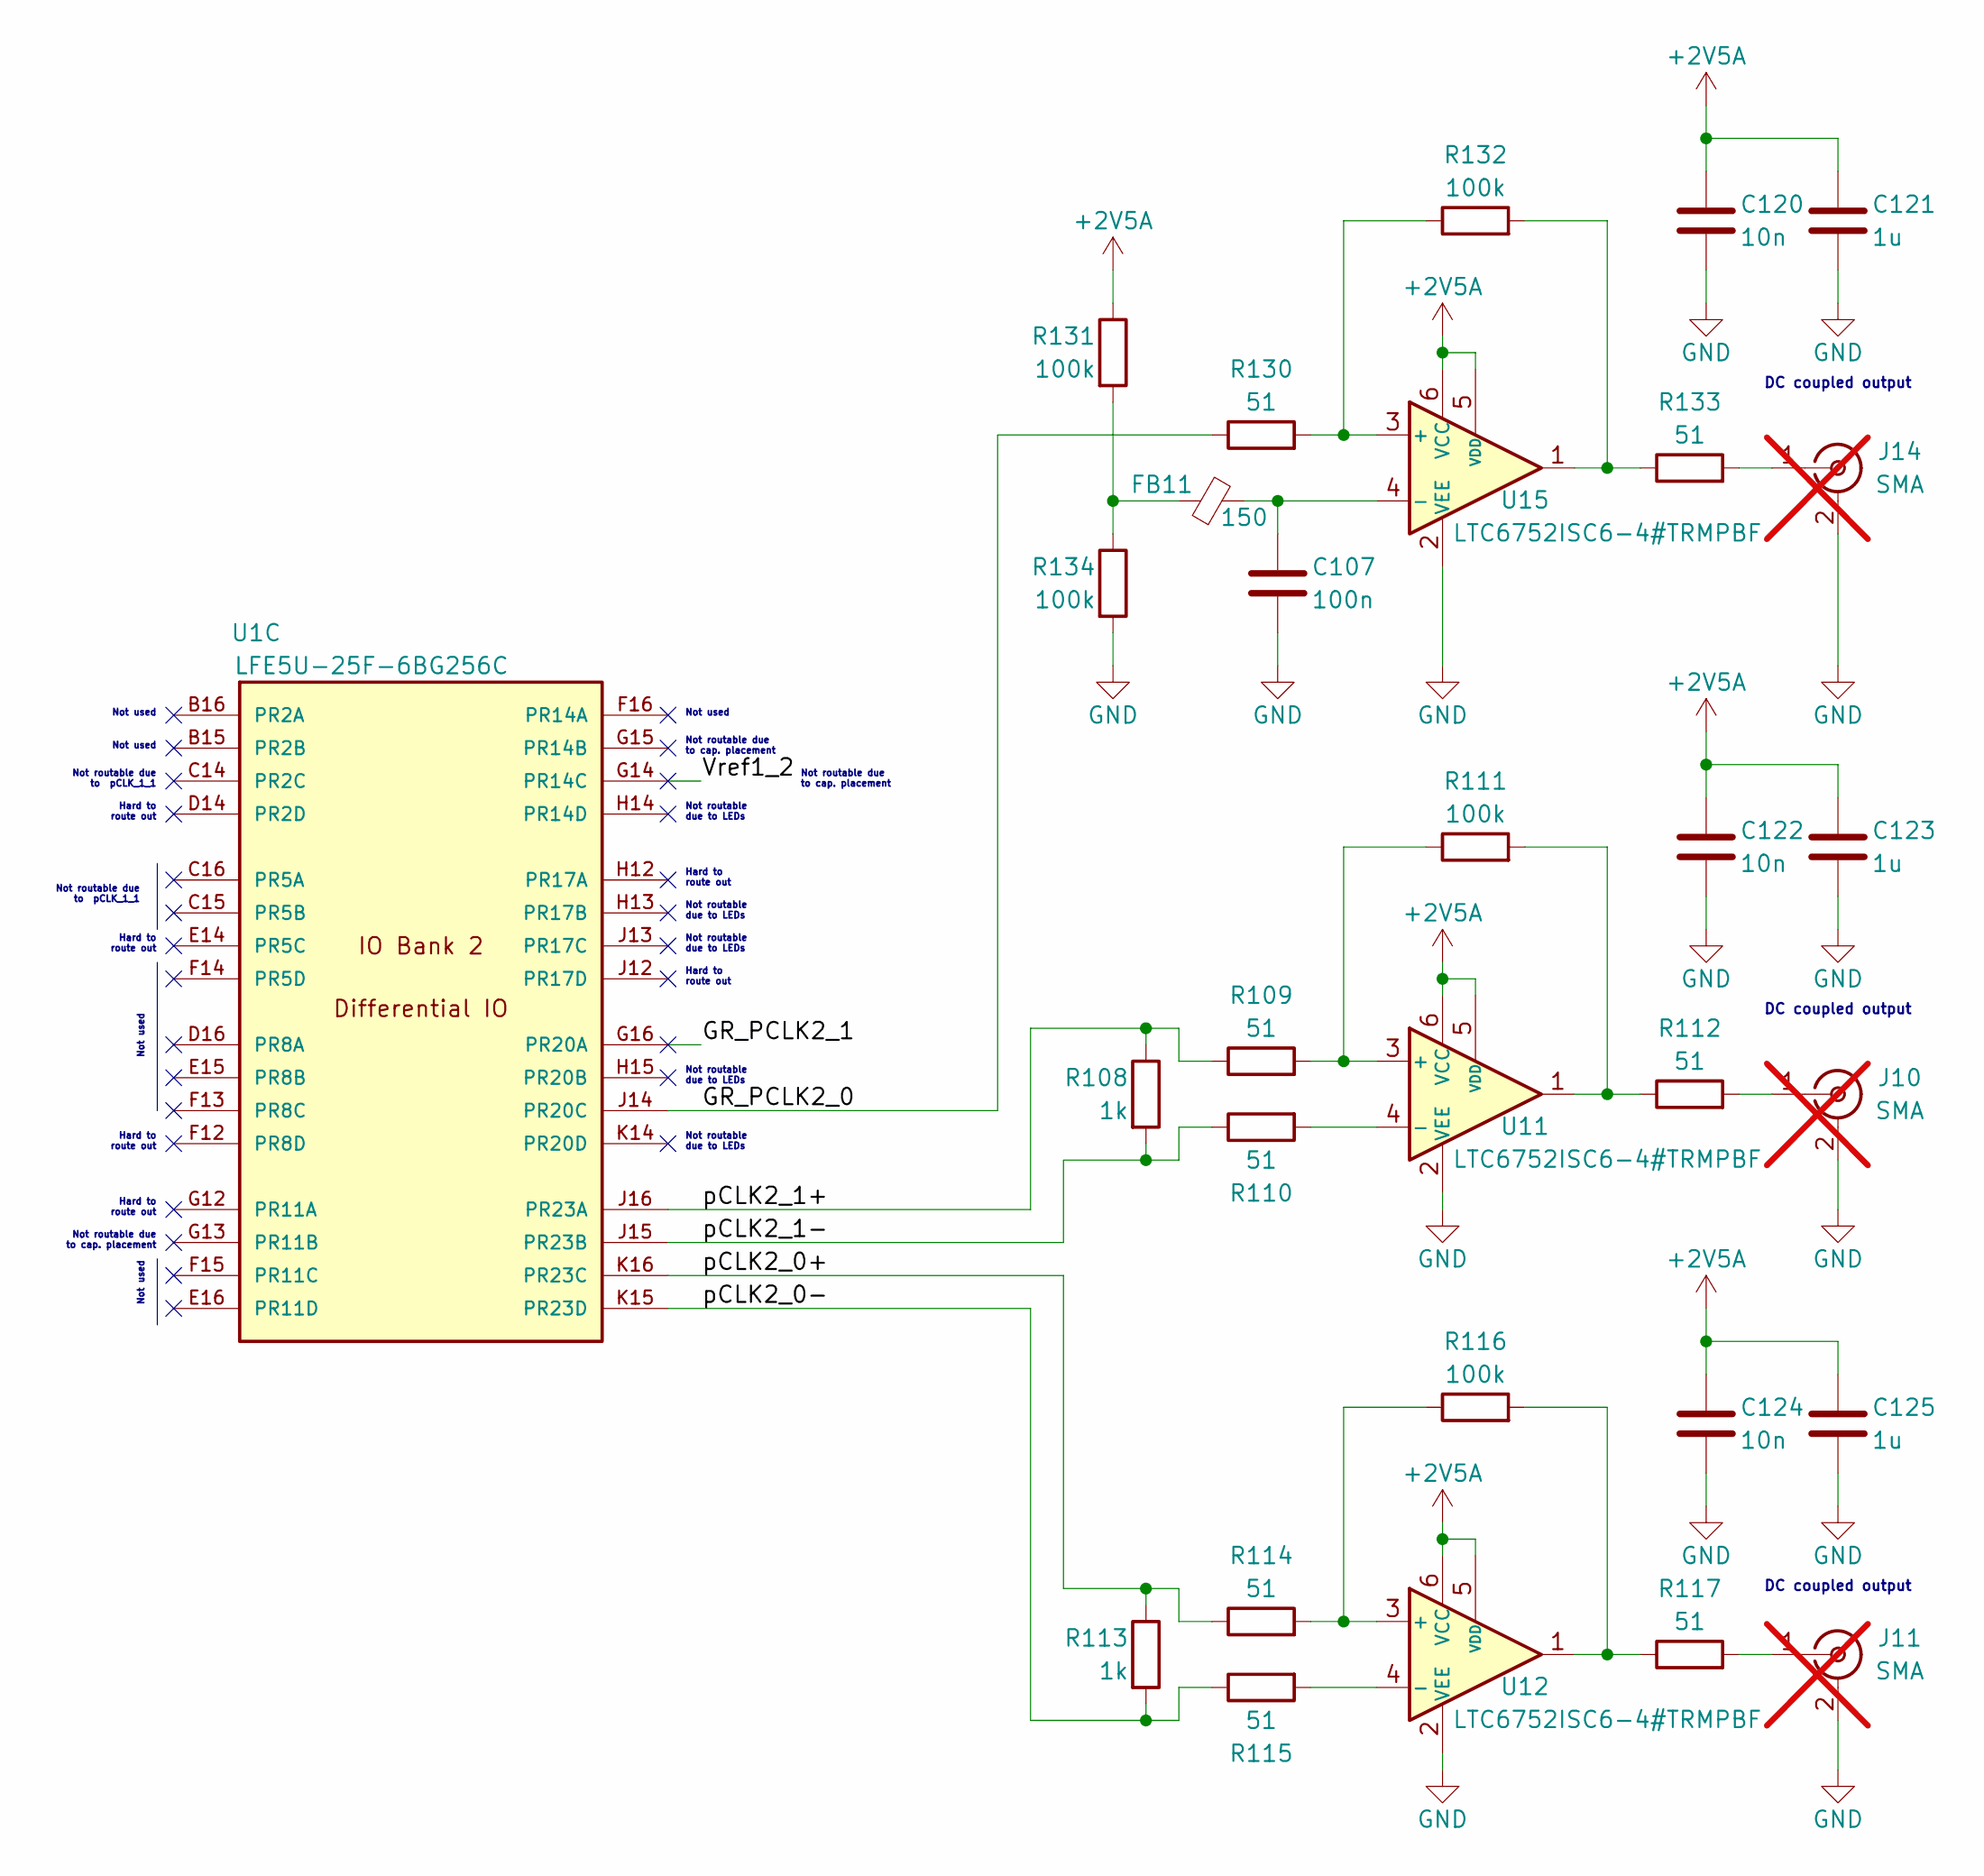
[picture p9: schematic IO_LVDS_Clocking_Bank2.kicad_sch]

Parts:
C107: 100n; C_0402_1005Metric
C120, C122, C124: 10n; C_0402_1005Metric
C121, C123, C125: 1u; C_0603_1608Metric
FB11: 150; L_0805_2012Metric
J10, J11, J14: SMA; 73251-115; not fitted
R108, R113: 1k; R_0402_1005Metric
R109, R110, R112, R114, R115, R117, R130, R133: 51; R_0402_1005Metric
R111, R116, R131, R132, R134: 100k; R_0402_1005Metric
U1: LFE5U-25F-6BG256C; BGA256C80P16X16_1400X1400X170_Masked
U11, U12, U15: LTC6752ISC6-4#TRMPBF; SOT-363_SC-70-6

Connections:
+2V5A: C120.1, C121.1, C122.1, C123.1, C124.1, C125.1, R131.1, U11.5 (VDD), U11.6 (VCC), U12.5 (VDD), U12.6 (VCC), U15.5 (VDD), U15.6 (VCC)
GND: C107.2, C120.2, C121.2, C122.2, C123.2, C124.2, C125.2, J10.2 (Ext), J11.2 (Ext), J14.2 (Ext), R134.2, U11.2 (VEE), U12.2 (VEE), U15.2 (VEE)
GR_PCLK2_0: R130.1, U1.J14 (PR20C)
GR_PCLK2_1: U1.G16 (PR20A)
unnamed: C107.1, FB11.2, U15.4 (-)
unnamed: FB11.1, R131.2, R134.1
unnamed: J10.1 (In), R112.2
unnamed: J11.1 (In), R117.2
unnamed: J14.1 (In), R133.2
unnamed: R109.2, R111.1, U11.3 (+)
unnamed: R110.2, U11.4 (-)
unnamed: R111.2, R112.1, U11.1
unnamed: R114.2, R116.1, U12.3 (+)
unnamed: R115.2, U12.4 (-)
unnamed: R116.2, R117.1, U12.1
unnamed: R130.2, R132.1, U15.3 (+)
unnamed: R132.2, R133.1, U15.1
Vref1_2: U1.G14 (PR14C)
pCLK2_0+: R113.1, R114.1, U1.K16 (PR23C)
pCLK2_0-: R113.2, R115.1, U1.K15 (PR23D)
pCLK2_1+: R108.1, R109.1, U1.J16 (PR23A)
pCLK2_1-: R108.2, R110.1, U1.J15 (PR23B)

Notes on the sheet:
Not used
DC coupled output
Not routable due to LEDs
Hard to route out
Not routable due to cap. placement
Not routable due to pCLK_1_1
