JulienKluge/Clock-odial/Power.kicad_sch

## KiCad design Power.kicad_sch (2025-08-21)

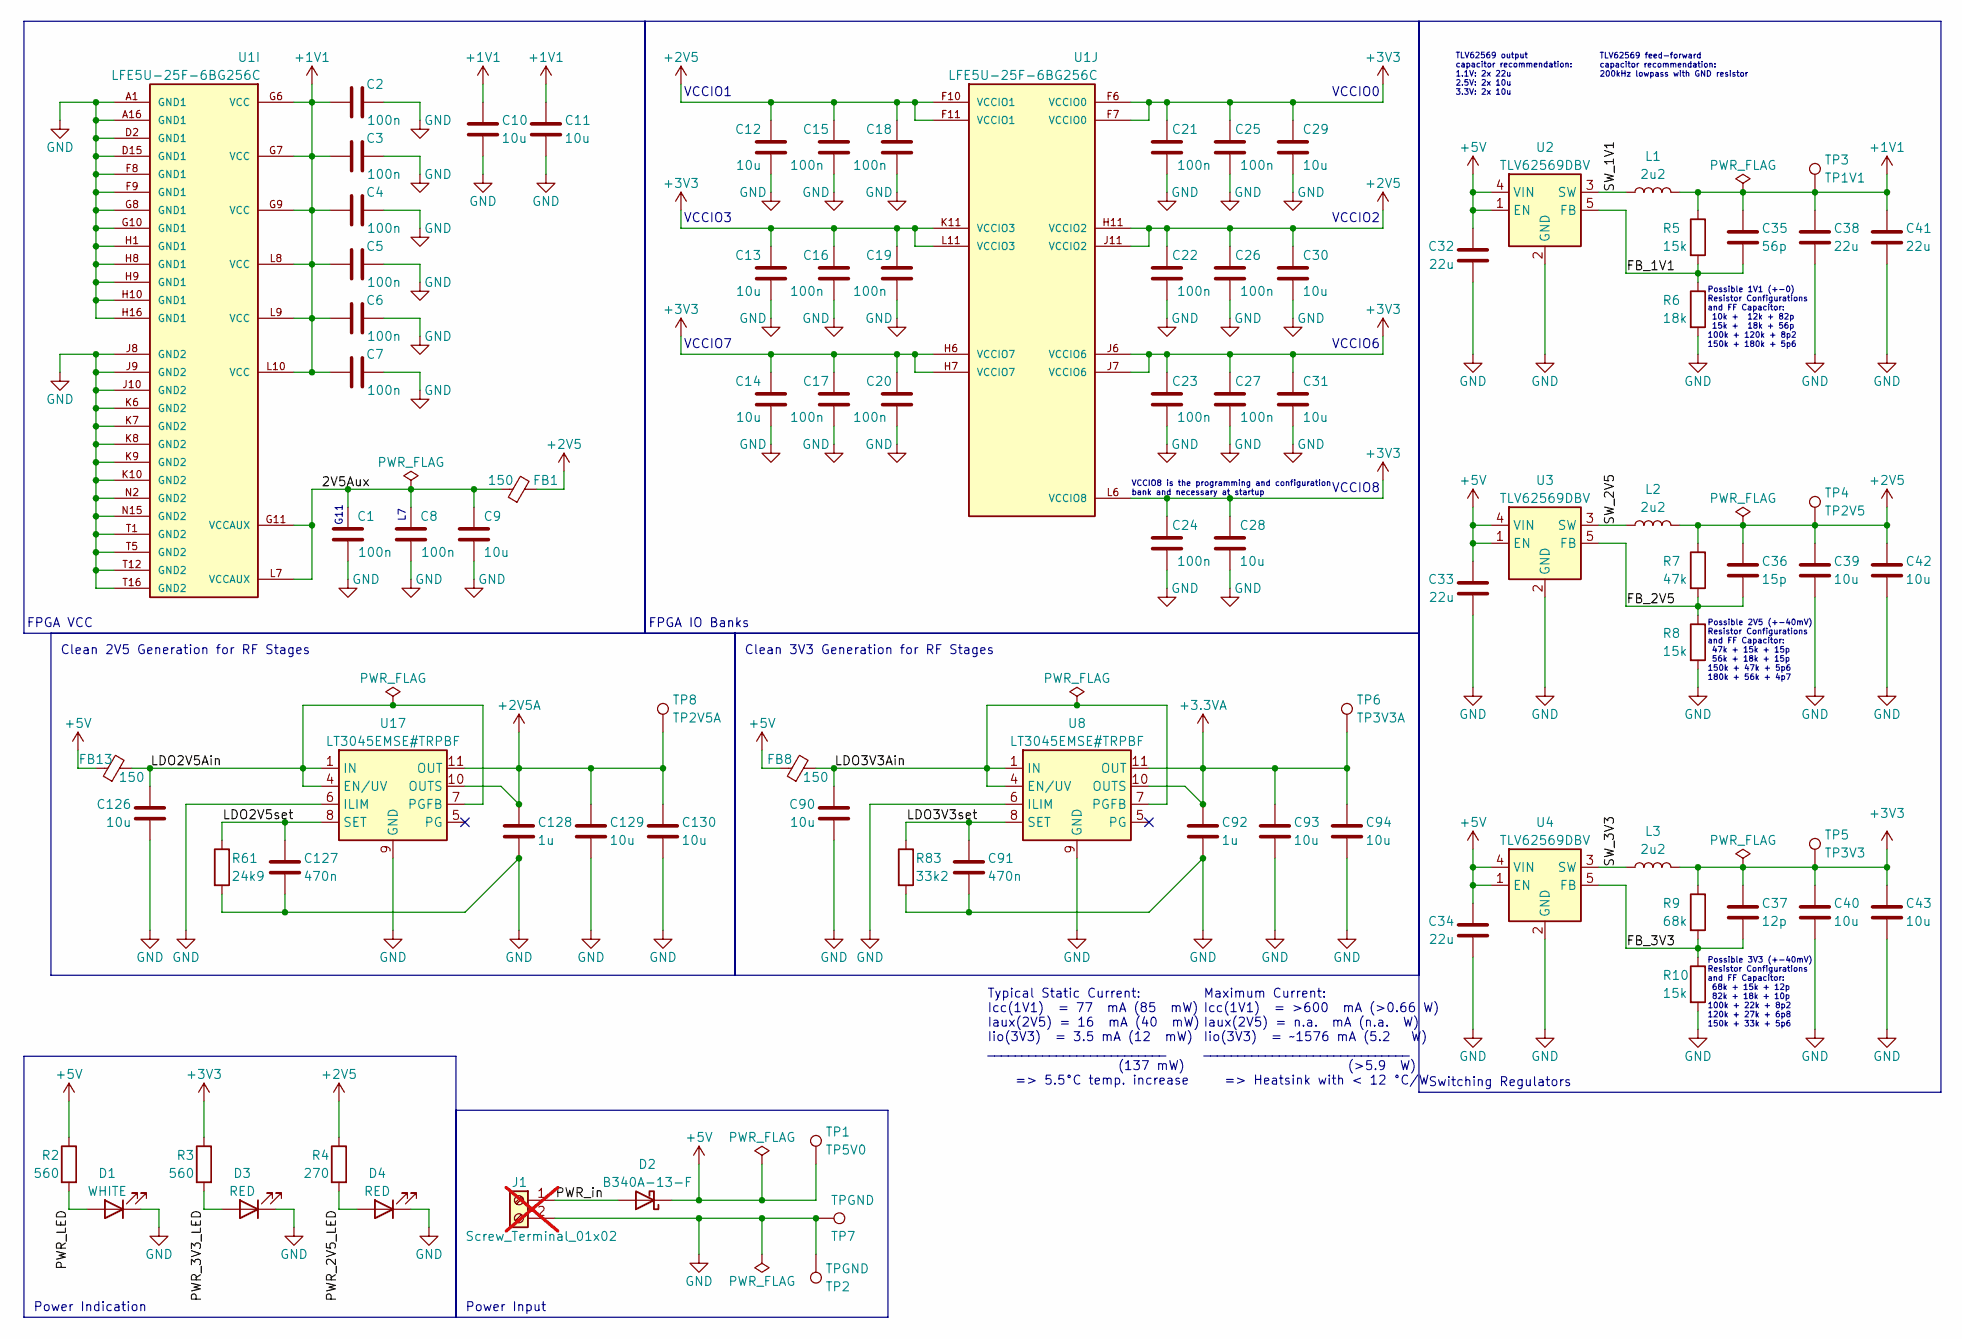
[picture p10: schematic Power.kicad_sch]

Parts:
C1, C2, C3, C4, C5, C6, C7, C8, C15, C16, C17, C18, C19, C20, C21, C22, C23, C24, C25, C26, C27: 100n; C_0402_1005Metric
C9, C10, C11, C12, C13, C14, C28, C29, C30, C31, C39, C40, C42, C43, C90, C93, C94, C126, C129, C130: 10u; C_0805_2012Metric
C32, C33, C34, C38, C41: 22u; C_0805_2012Metric
C35: 56p; C_0402_1005Metric
C36: 15p; C_0402_1005Metric
C37: 12p; C_0402_1005Metric
C91, C127: 470n; C_0603_1608Metric
C92, C128: 1u; C_0805_2012Metric
D1: WHITE; LED_0603_1608Metric
D2: B340A-13-F; D_SMA
D3, D4: RED; LED_0603_1608Metric
FB1, FB8, FB13: 150; L_0805_2012Metric
J1: Screw_Terminal_01x02; TerminalBlock_TE_282834-2_1x02_P2.54mm_Horizontal_Modified; not fitted
L1, L2, L3: 2u2; IND_LQH3NPN2R2MMEL
R2, R3: 560; R_0402_1005Metric
R4: 270; R_0402_1005Metric
R5, R8, R10: 15k; R_0402_1005Metric
R6: 18k; R_0402_1005Metric
R7: 47k; R_0402_1005Metric
R9: 68k; R_0402_1005Metric
R61: 24k9; R_0402_1005Metric
R83: 33k2; R_0402_1005Metric
TP1: TP5V0; TestPoint_Pad_D3.0mm
TP2, TP7: TPGND; TestPoint_Pad_D3.0mm
TP3: TP1V1; TestPoint_Pad_D3.0mm
TP4: TP2V5; TestPoint_Pad_D3.0mm
TP5: TP3V3; TestPoint_Pad_D3.0mm
TP6: TP3V3A; TestPoint_Pad_D3.0mm
TP8: TP2V5A; TestPoint_Pad_D3.0mm
U1: LFE5U-25F-6BG256C; BGA256C80P16X16_1400X1400X170_Masked
U2, U3, U4: TLV62569DBV; SOT-23-5
U8, U17: LT3045EMSE#TRPBF; MSOP-12-1EP_3x4.039mm_P0.65mm_EP1.651x2.845mm

Connections:
2V5Aux: C1.1, C8.1, C9.1, FB1.1, U1.G11 (VCCAUX), U1.L7 (VCCAUX)
+1V1: C2.1, C3.1, C4.1, C5.1, C6.1, C7.1, C10.1, C11.1, C35.1, C38.1, C41.1, L1.2, R5.1, TP3.1, U1.G6 (VCC), U1.G7 (VCC), U1.G9 (VCC), U1.L8 (VCC), U1.L9 (VCC), U1.L10 (VCC)
+2V5: C12.1, C15.1, C18.1, C22.1, C26.1, C30.1, C36.1, C39.1, C42.1, FB1.2, L2.2, R4.1, R7.1, TP4.1, U1.F10 (VCCIO1), U1.F11 (VCCIO1), U1.H11 (VCCIO2), U1.J11 (VCCIO2)
+2V5A: C128.1, C129.1, C130.1, TP8.1, U17.10 (OUTS), U17.11 (OUT), U17.12 (OUT)
+3.3VA: C92.1, C93.1, C94.1, TP6.1, U8.10 (OUTS), U8.11 (OUT), U8.12 (OUT)
+3V3: C13.1, C14.1, C16.1, C17.1, C19.1, C20.1, C21.1, C23.1, C24.1, C25.1, C27.1, C28.1, C29.1, C31.1, C37.1, C40.1, C43.1, L3.2, R3.1, R9.1, TP5.1, U1.F6 (VCCIO0), U1.F7 (VCCIO0), U1.H6 (VCCIO7), U1.H7 (VCCIO7), U1.J6 (VCCIO6), U1.J7 (VCCIO6), U1.K11 (VCCIO3), U1.L6 (VCCIO8), U1.L11 (VCCIO3)
+5V: C32.1, C33.1, C34.1, D2.1 (K), FB8.1, FB13.1, R2.1, TP1.1, U2.1 (EN), U2.4 (VIN), U3.1 (EN), U3.4 (VIN), U4.1 (EN), U4.4 (VIN)
FB_1V1: C35.2, R5.2, R6.1, U2.5 (FB)
FB_2V5: C36.2, R7.2, R8.1, U3.5 (FB)
FB_3V3: C37.2, R9.2, R10.1, U4.5 (FB)
GND: C1.2, C2.2, C3.2, C4.2, C5.2, C6.2, C7.2, C8.2, C9.2, C10.2, C11.2, C12.2, C13.2, C14.2, C15.2, C16.2, C17.2, C18.2, C19.2, C20.2, C21.2, C22.2, C23.2, C24.2, C25.2, C26.2, C27.2, C28.2, C29.2, C30.2, C31.2, C32.2, C33.2, C34.2, C38.2, C39.2, C40.2, C41.2, C42.2, C43.2, C90.2, C91.2, C92.2, C93.2, C94.2, C126.2, C127.2, C128.2, C129.2, C130.2, D1.1 (K), D3.1 (K), D4.1 (K), J1.2, R6.2, R8.2, R10.2, R61.2, R83.2, TP2.1, TP7.1, U1.A1 (GND1), U1.A16 (GND1), U1.D2 (GND1), U1.D15 (GND1), U1.F8 (GND1), U1.F9 (GND1), U1.G8 (GND1), U1.G10 (GND1), U1.H1 (GND1), U1.H8 (GND1), U1.H9 (GND1), U1.H10 (GND1), U1.H16 (GND1), U1.J8 (GND2), U1.J9 (GND2), U1.J10 (GND2), U1.K6 (GND2), U1.K7 (GND2), U1.K8 (GND2), U1.K9 (GND2), U1.K10 (GND2), U1.N2 (GND2), U1.N15 (GND2), U1.T1 (GND2), U1.T5 (GND2), U1.T12 (GND2), U1.T16 (GND2), U2.2 (GND), U3.2 (GND), U4.2 (GND), U8.6 (ILIM), U8.9 (GND), U8.13 (GND), U17.6 (ILIM), U17.9 (GND), U17.13 (GND)
LDO2V5Ain: C126.1, FB13.2, U17.1 (IN), U17.2 (IN), U17.3 (IN), U17.4 (EN/UV), U17.7 (PGFB)
LDO2V5set: C127.1, R61.1, U17.8 (SET)
LDO3V3Ain: C90.1, FB8.2, U8.1 (IN), U8.2 (IN), U8.3 (IN), U8.4 (EN/UV), U8.7 (PGFB)
LDO3V3set: C91.1, R83.1, U8.8 (SET)
PWR_2V5_LED: D4.2 (A), R4.2
PWR_3V3_LED: D3.2 (A), R3.2
PWR_LED: D1.2 (A), R2.2
PWR_in: D2.2 (A), J1.1
SW_1V1: L1.1, U2.3 (SW)
SW_2V5: L2.1, U3.3 (SW)
SW_3V3: L3.1, U4.3 (SW)

Notes on the sheet:
Possible 3V3 (+-40mV) Resistor Configurations and FF Capacitor: 68k + 15k + 12p 82k + 18k + 10p 100k + 22k + 8p2 120k + 27k + 6p8 150k + 33k + 5p6
VCCIO3
VCCIO1
FPGA IO Banks
Power Indication
Switching Regulators
TLV62569 output capacitor recommendation: 1.1V: 2x 22u 2.5V: 2x 10u 3.3V: 2x 10u
G11
VCCIO7
VCCIO0
Possible 1V1 (+-0) Resistor Configurations and FF Capacitor: 10k + 12k + 82p 15k + 18k + 56p 100k + 120k + 8p2 150k + 180k + 5p6
Typical Static Current: Icc(1V1) = 77 mA (85 mW) Iaux(2V5) = 16 mA (40 mW) Iio(3V3) = 3.5 mA (12 mW) __________________________ (137 mW) => 5.5°C temp. increase
Maximum Current: Icc(1V1) = >600 mA (>0.66 W) Iaux(2V5) = n.a. mA (n.a. W) Iio(3V3) = ~1576 mA (5.2 W) ______________________________ (>5.9 W) => Heatsink with < 12 °C/W
TLV62569 feed-forward capacitor recommendation: 200kHz lowpass with GND resistor
Clean 2V5 Generation for RF Stages
VCCIO8
Clean 3V3 Generation for RF Stages
VCCIO6
Possible 2V5 (+-40mV) Resistor Configurations and FF Capacitor: 47k + 15k + 15p 56k + 18k + 15p 150k + 47k + 5p6 180k + 56k + 4p7
Power Input
FPGA VCC
VCCIO2
VCCIO8 is the programming and configuration bank and necessary at startup
