JulienKluge/Clock-odial/Prog_Dbg_Interface.kicad_sch

## KiCad design Prog_Dbg_Interface.kicad_sch (2025-08-22)

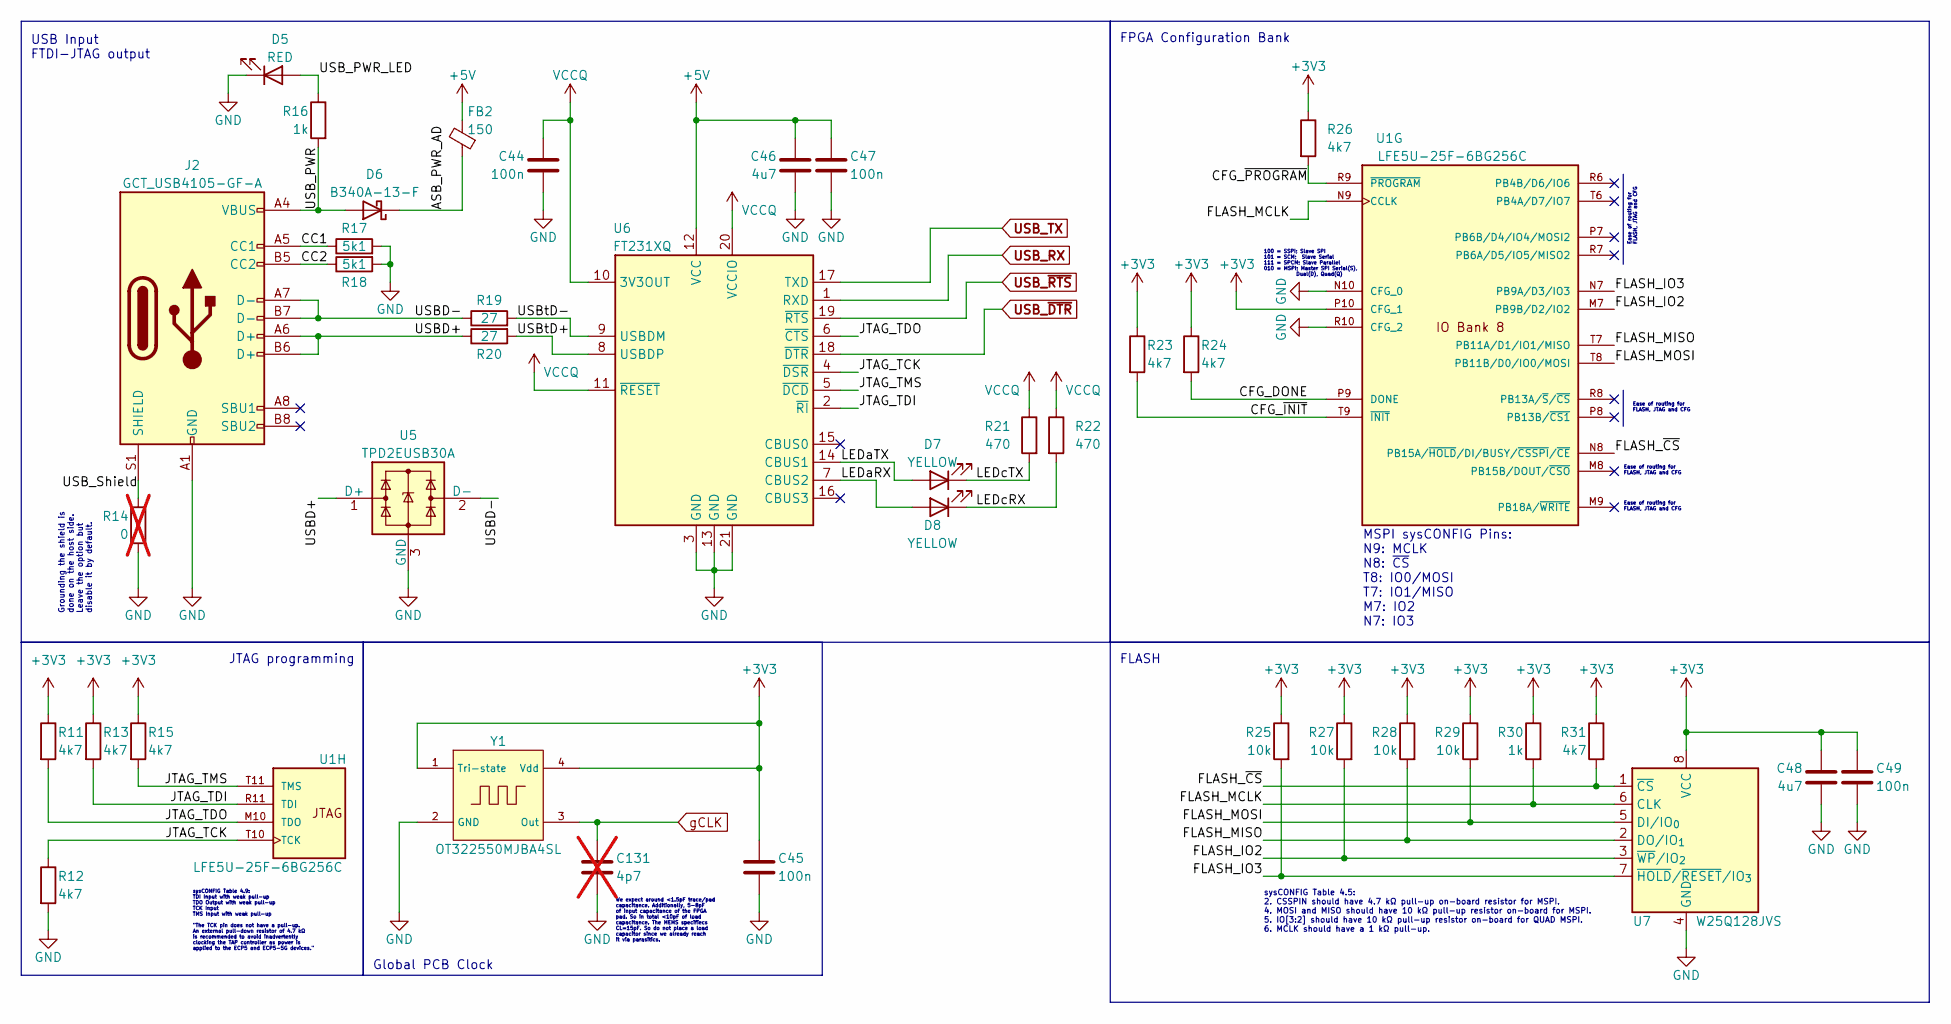
[picture p11: schematic Prog_Dbg_Interface.kicad_sch]

Parts:
C44, C45, C47, C49: 100n; C_0402_1005Metric
C46, C48: 4u7; C_0603_1608Metric
C131: 4p7; C_0402_1005Metric; not fitted
D5: RED; LED_0603_1608Metric
D6: B340A-13-F; D_SMA
D7, D8: YELLOW; LED_0603_1608Metric
FB2: 150; L_0805_2012Metric
J2: GCT_USB4105-GF-A; GCT_USB4105-GF-A_Modified
R11, R12, R13, R15, R23, R24, R26, R31: 4k7; R_0402_1005Metric
R14: 0; R_0603_1608Metric_Pad0.98x0.95mm_HandSolder; not fitted
R16, R30: 1k; R_0402_1005Metric
R17, R18: 5k1; R_0402_1005Metric
R19, R20: 27; R_0402_1005Metric
R21, R22: 470; R_0402_1005Metric
R25, R27, R28, R29: 10k; R_0402_1005Metric
U1: LFE5U-25F-6BG256C; BGA256C80P16X16_1400X1400X170_Masked
U5: TPD2EUSB30A; Texas_DRT-3
U6: FT231XQ; QFN-20-1EP_4x4mm_P0.5mm_EP2.5x2.5mm
U7: W25Q128JVS; SOIC-8_5.3x5.3mm_P1.27mm
Y1: OT322550MJBA4SL; Crystal_SMD_3225-4Pin_3.2x2.5mm

Connections:
+3V3: C45.1, C48.1, C49.1, R11.1, R13.1, R15.1, R23.1, R24.1, R25.1, R26.1, R27.1, R28.1, R29.1, R30.1, R31.1, U1.P10 (CFG_1), U7.8 (VCC), Y1.1 (Tri-state), Y1.4 (Vdd)
+5V: C46.1, C47.1, FB2.2, U6.12 (VCC)
ASB_PWR_AD: D6.1 (K), FB2.1
CC1: J2.A5 (CC1), R17.1
CC2: J2.B5 (CC2), R18.1
CFG_DONE: R24.2, U1.P9 (DONE)
CFG_~INIT: R23.2, U1.T9 (~INIT)
CFG_~PROGRAM: R26.2, U1.R9 (~PROGRAM)
FLASH_IO2: R27.2, U1.M7 (PB9B/D2/IO2), U7.3 (~WP/IO_{2})
FLASH_IO3: R25.2, U1.N7 (PB9A/D3/IO3), U7.7 (~HOLD/~RESET/IO_{3})
FLASH_MCLK: R30.2, U1.N9 (CCLK), U7.6 (CLK)
FLASH_MISO: R28.2, U1.T7 (PB11A/D1/IO1/MISO), U7.2 (DO/IO_{1})
FLASH_MOSI: R29.2, U1.T8 (PB11B/D0/IO0/MOSI), U7.5 (DI/IO_{0})
FLASH_~CS: R31.2, U1.N8 (PB15A/~HOLD/DI/BUSY/~CSSPI/~CE), U7.1 (~CS)
GND: C44.2, C45.2, C46.2, C47.2, C48.2, C49.2, C131.2, D5.1 (K), J2.A1 (GND), J2.A12 (GND), J2.B1 (GND), J2.B12 (GND), R12.2, R14.2, R17.2, R18.2, U1.N10 (CFG_0), U1.R10 (CFG_2), U5.3 (GND), U6.3 (GND), U6.13 (GND), U6.21 (GND), U7.4 (GND), Y1.2 (GND)
JTAG_TCK: R12.1, U1.T10 (TCK), U6.4 (~DSR)
JTAG_TDI: R13.2, U1.R11 (TDI), U6.2 (~RI)
JTAG_TDO: R11.2, U1.M10 (TDO), U6.6 (~CTS)
JTAG_TMS: R15.2, U1.T11 (TMS), U6.5 (~DCD)
LEDaRX: D8.2 (A), U6.7 (CBUS2)
LEDaTX: D7.2 (A), U6.14 (CBUS1)
LEDcRX: D8.1 (K), R22.2
LEDcTX: D7.1 (K), R21.2
USBD+: J2.A6 (D+), J2.B6 (D+), R20.1, U5.1 (D+)
USBD-: J2.A7 (D-), J2.B7 (D-), R19.1, U5.2 (D-)
USB_PWR: D6.2 (A), J2.A4 (VBUS), J2.A9 (VBUS), J2.B4 (VBUS), J2.B9 (VBUS), R16.2
USB_PWR_LED: D5.2 (A), R16.1
USB_RX: U6.1 (RXD)
USB_Shield: J2.S1 (SHIELD), R14.1
USB_TX: U6.17 (TXD)
USB_~DTR: U6.18 (~DTR)
USB_~RTS: U6.19 (~RTS)
USBtD+: R20.2, U6.8 (USBDP)
USBtD-: R19.2, U6.9 (USBDM)
VCCQ: C44.1, R21.1, R22.1, U6.10 (3V3OUT), U6.11 (~RESET), U6.20 (VCCIO)
gCLK: C131.1, Y1.3 (Out)

Notes on the sheet:
Global PCB Clock
MSPI sysCONFIG Pins: N9: MCLK N8: ~{CS} T8: IO0/MOSI T7: IO1/MISO M7: IO2 N7: IO3
Ease of routing for FLASH, JTAG and CFG
FLASH
We expect around <1.5pF trace/pad capacitance. Additionally, 5-8pF of input capacitance of the FPGA pad. So in total <10pF of load capacitance. The MEMS specifiecs CL=15pF. So do not place a load capacitor since we already reach it via parasitics.
sysCONFIG Table 4.5: 2. CSSPIN should have 4.7 kΩ pull-up on-board resistor for MSPI. 4. MOSI and MISO should have 10 kΩ pull-up resistor on-board for MSPI. 5. IO[3:2] should have 10 kΩ pull-up resistor on-board for QUAD MSPI. 6. MCLK should have a 1 kΩ pull-up.
FPGA Configuration Bank
100 = SSPI; Slave SPI 101 = SCM; Slave Serial 111 = SPCM; Slave Parallel 010 = MSPI; Master SPI Serial(S), Dual(D), Quad(Q)
USB Input FTDI-JTAG output
sysCONFIG Table 4.9: TDI Input with weak pull-up TDO Output with weak pull-up TCK Input TMS Input with weak pull-up "The TCK pin does not have a pull-up. An external pull-down resistor of 4.7 kΩ is recommended to avoid inadvertently clocking the TAP controller as power is applied to the ECP5 and EC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
Grounding the shield is done on the host side. Leave the option but disable it by default.
JTAG programming
