JulienKluge/Clock-odial/(commit log)

2025-08-21 Initial Data Push
    [CF125C_M-Step.ipt, Clock-odial.kicad_sch, Clock_Input_Diff_Out.kicad_sch, Clock_Input_SingleEnded_Out.kicad_sch, FPGA-SC-02033-2-0-ECP5U-25-Pinout.xlsx, IO_Bank0.kicad_sch, IO_Bank3.kicad_sch, IO_LVDS_Clocking_Bank1.kicad_sch]
2025-08-22 Document A bit and add more silkscreen
    [Clock-odial.kicad_sch, Clock_Input_SingleEnded_Out.kicad_sch, Prog_Dbg_Interface.kicad_sch]
